frosted123456/Fishing_system_v2/log/chalet_ball_d102_d103.png

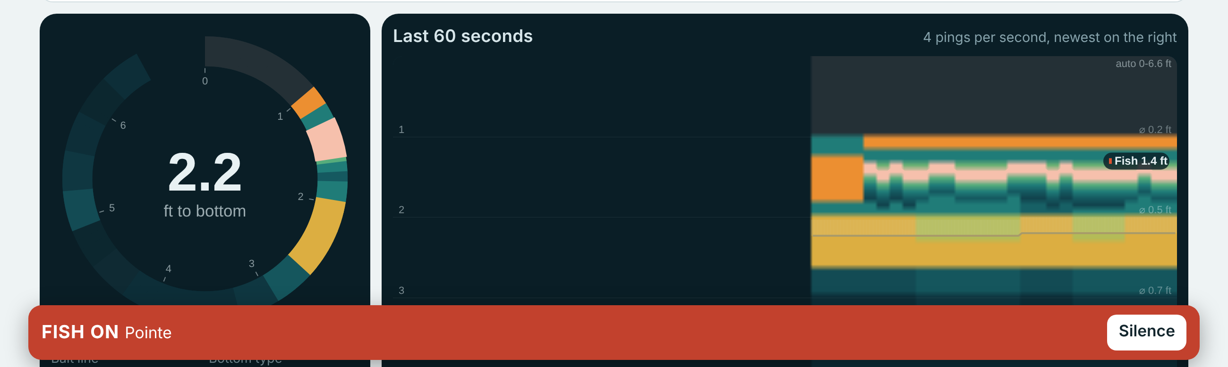
log/chalet_ball_d102_d103.png
