frosted123456/Fishing_system_v2/log/chalet_ball_fine_cells.png

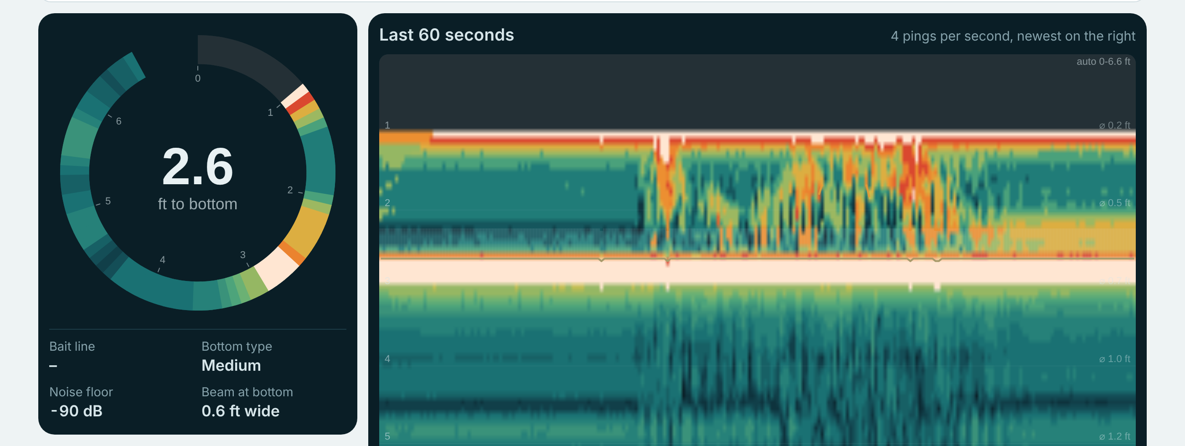
log/chalet_ball_fine_cells.png
