frosted123456/Fishing_system_v2/log/chain_ball_test_2026-11-05.png

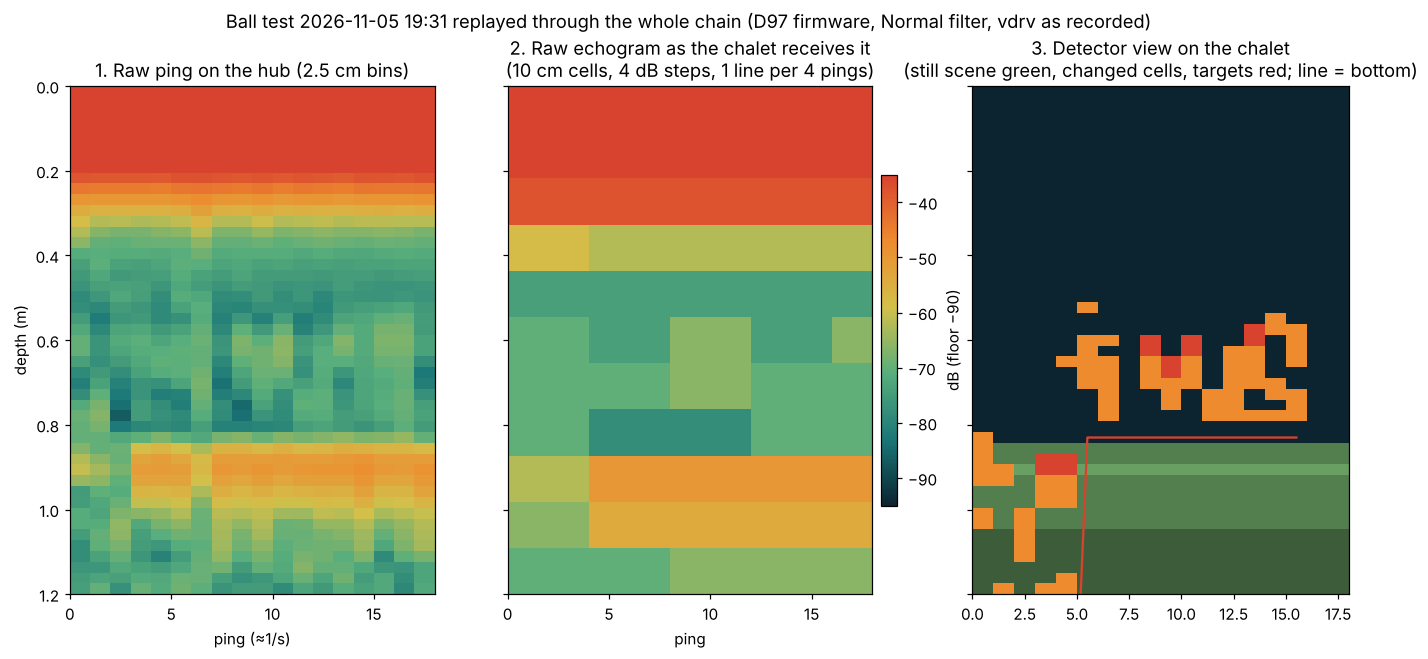
log/chain_ball_test_2026-11-05.png
