frosted123456/Fishing_system_v2/src/lora_node/mesh_radio.cpp

// TDMA LoRa mesh — radio task. See mesh_radio.h and docs/protocol_v2.md.
//
// Timing: every slot time is relative to REF = start of the chalet beacon, computed as
// TxDone - airtime(beacon) at the chalet and RxDone - airtime(beacon) at a hub (or from a relay
// hub's ECHO), so REF is exactly periodic whatever the beacon length. Interrupt
// times are taken in the DIO1 ISR with esp_timer_get_time(); TX starts are placed with
// vTaskDelay + a short busy-wait. Values marked "est." are estimates for the radio test mode.
#include "mesh_radio.h"
#include <RadioLib.h>
#include <new>
#include <esp_heap_caps.h>
#include <esp_timer.h>
#include <esp_system.h>
#include <freertos/FreeRTOS.h>
#include <freertos/task.h>
#include <freertos/semphr.h>
#include <freertos/queue.h>
#include "config.h"
#include <hub_role.h>
#include <follow_action.h>   // D80
#include <chalet_role.h>
#include <sonar_link.h>
#include <eb_link.h>
#include <sonar_sim.h>

using namespace icemesh;
using namespace icemesh::tdma;

// ---------------------------------------------------------------------------------------------
// Radio + shared state
// ---------------------------------------------------------------------------------------------
// D84: RadioLib keeps getMod() protected; the fallback-mode command after begin() needs it (see meshRadioBegin)
struct Sx1262Radio : public SX1262 { using SX1262::SX1262; Module* module() { return getMod(); } };
static Sx1262Radio radio = new Module(LORA_CS, LORA_DIO1, LORA_RST, LORA_BUSY, SPI, SPISettings(8000000, MSBFIRST, SPI_MODE0));   // radio review: 8 MHz halves the per-byte cost of a 255 B packet

static TaskHandle_t g_task = nullptr;
static SemaphoreHandle_t g_mx = nullptr;
static QueueHandle_t g_nodeq = nullptr;

static volatile bool g_irq = false;
static volatile uint32_t g_irq_us = 0;

static bool g_chalet = false;
static bool g_radio_ok = false;
static uint8_t g_net = 0x42;
static RadioMode g_cur_mode = MODE_COUNT;

static HubRole<24>* g_hub = nullptr;
static ChaletRole<10, 48>* g_ch = nullptr;   // 10 hubs, 48 nodes (3 tip-ups per hub + spares)

// counters (written by the task, read by loop)
static volatile uint32_t g_rx_ok = 0, g_rx_crc = 0, g_tx = 0, g_last_rx_ms = 0;
static volatile uint16_t g_frame = 0;

// hub side state shared with loop
static volatile uint16_t g_battery_mv = 0;
static volatile uint8_t g_silence_req = 0;        // HF_SILENCE_ON / HF_SILENCE_OFF while pending
static volatile uint8_t g_silence_req_frames = 0;
static volatile bool g_silence_event = false;
static volatile bool g_silence_state = false;
static volatile bool g_reset_event = false;
// Survives ESP.restart() (not power-off): the RESET ALL already executed, so the beacon repeating it
// for 5 s does not reboot this hub a second time.
RTC_NOINIT_ATTR static uint32_t g_rtc_cmd_magic;
RTC_NOINIT_ATTR static uint8_t g_rtc_cmd_seq;
static uint32_t g_test_counter = 0;
static uint16_t g_last_beacon_len = 40;

// chalet side config shared with loop
static volatile uint8_t g_cfg_test = TEST_OFF;
static volatile bool g_cfg_adaptive = false;
static volatile bool g_cfg_reset_stats = false;
static volatile uint8_t g_cfg_focus = 0;
// D81 (5.1): frames are 0.5-2 s long: ages for people and the follower are in seconds
static uint16_t frameAgeS(uint16_t frame_then);
static uint16_t frameAgeS(uint16_t frame_then) {
  const uint16_t fm = (g_chalet && g_ch != nullptr && g_ch->planner.frameMs()) ? g_ch->planner.frameMs() : 1000;
  const uint32_t frames = static_cast<uint16_t>(g_frame - frame_then);
  const uint32_t ms = frames * fm;
  return ms > 65535000UL ? 65535 : static_cast<uint16_t>(ms / 1000UL);
}
static volatile uint8_t g_cfg_range_hub = 0;          // D80 range test hub (0 = off)
static RangeRing<64> g_range_ring;                     // D80 slot results of that hub (radio task -> loop)
static sonar::FollowAction g_follow;                   // D80 follow the action (chalet, loop() only)
static volatile bool g_cfg_reset_all = false;
static volatile bool g_cfg_sonar_sim = false;
// D70: the chalet keeps the last wiring-check result of each hole (SEC_SELFTEST), on top of the sonar store
static constexpr uint16_t SONAR_RING = 96;   // D84c: pings kept (was 128); 3 streamed holes = 32 each, the page polls every 2 s
static constexpr uint8_t SONAR_HIST = 60;    // D84c: summaries per hole for the glance views, 2 min at one per 2 s (was 90 = 3 min)
struct ChaletSink : public sonar::SonarStore<16, SONAR_RING, SONAR_HIST> {
  struct R { uint8_t node; uint8_t r[12]; uint32_t at_ms; };
  R st[16]; uint8_t st_n = 0;
  R tn[16]; uint8_t tn_n = 0;   // D141: last transducer-tune result of each hole (same section, 12 B with version 2)
  void onSelfTest(uint8_t, uint8_t node, const uint8_t* r12, uint16_t) override {
    const bool tune = r12[0] == 2;   // icemesh::sonar::TUNE_RESULT_VER
    R* a = tune ? tn : st; uint8_t& n = tune ? tn_n : st_n;
    R* p = nullptr;
    for (uint8_t i = 0; i < n && p == nullptr; i++) if (a[i].node == node) p = &a[i];
    if (p == nullptr) { if (n < 16) p = &a[n++]; else p = &a[0]; }
    p->node = node; memcpy(p->r, r12, 12); p->at_ms = millis() ? millis() : 1;
  }
};
static ChaletSink* g_sonar = nullptr;   // chalet only (~35 KB: ping ring 96 x 112 B, 16 holes x 564 B, history 16 x 60 x 16 B; D84c shrank it from 46 KB for heap room with the demo)
static uint8_t g_cmd_seq = 0;
static uint32_t g_silence_until_ms = 0;
static uint8_t g_self = 0;

// ---- v2 network config: LoRa channel, transport, ESP-NOW backbone (docs/protocol_v2.md §6c) ----
// Values marked est. come from the simulation (docs/SIM_RESULTS.md), not from field measurements.
static const int16_t BUSY_ABOVE_X10 = 80;       // est.: a sample 8 dB above the channel's own noise floor counts as activity (D84h)
static const uint8_t CH_BUSY_PCT = 25;          // est.: Auto moves away from a channel busier than this...
static const uint8_t CH_BETTER_PCT = 15;        // ...when another one is quieter by at least this much
static const uint32_t CH_EVAL_MS = 60000;
static const uint32_t SCAN_DWELL_US = 60000;    // chalet: one other channel sampled per frame (between frames)
static const uint32_t BOOT_SCAN_US = 250000;    // chalet: per channel at boot (Auto)
static const uint32_t HUB_HOP_MS = 2500;        // hub without beacon: next channel every 2.5 s...
static const uint32_t HUB_HOP_QUIET_MS = 10000; // ...unless this network was heard in the last 10 s
static const uint8_t CMD_BEACONS = 6;           // each beacon command is repeated in 6 beacons (SET_CHANNEL: target 5..0)
static const uint8_t CMD_BEACONS_KNOB = 3;      // D68: sonar knobs (22 of them on every new hub) take 3: a hub out of a beacon
                                                // or two still gets them, and the queue drains in a minute instead of two
static const bool EB_LR = ESPNOW_LONG_RANGE_MODE;   // backbone rate follows the ice side (LR on hubs and tip-ups)

static volatile uint8_t g_lora_ch = 0;          // network channel
static uint8_t g_tuned_ch = 0;                  // channel the SX1262 is tuned to (radio task only)
static volatile uint8_t g_req_ch = 0xFF;        // hub: channel named by a backbone beacon (applied by the radio task)
static volatile uint32_t g_heard_net_ms = 0;    // hub: last packet of this network (LoRa) or backbone channel hint
static uint32_t g_last_hop_ms = 0;
static volatile uint32_t g_pending_since_ms = 0;
static volatile bool g_lora_idle = false;       // hub: LoRa off (ESP-NOW only)
static volatile bool g_ch_event = false;
static volatile uint8_t g_cfg_transport = TR_AUTO;
static volatile uint8_t g_cfg_channel = MESH_CH_AUTO;
static volatile bool g_cfg_rescan = false;
static volatile uint8_t g_busy_pct[LORA_CHANNELS] = {255, 255, 255, 255, 255, 255, 255, 255};
static uint32_t g_busy_n[LORA_CHANNELS], g_busy_hit[LORA_CHANNELS];   // radio task only
// D84h/i: noise floor per channel = the running MEDIAN of the RSSI samples, dBm x10 (0 = none yet): each sample
// moves it 0.1 dB towards itself, so it settles where half the samples are below. (D84h tracked the lowest sample:
// the SX1262 instantaneous RSSI jitters ±10 dB, one low outlier became the floor and everything read 99 %.) A fixed
// -100 dBm threshold read 70-98 % on every channel indoors: the BW500 floor sits near -105 and the board's own
// noise peaks above -100. With the median, quiet noise gives a few %, a real transmitter on the channel much more.
static volatile int16_t g_floor_x10[LORA_CHANNELS];
static uint8_t g_scan_rr = 0;
static uint32_t g_ch_eval_ms = 0;
static volatile uint16_t g_ch_moves = 0;
static uint8_t g_ch_switch_after = 0xFF;        // chalet: retune at the end of this frame
static volatile uint32_t g_eb_beacon_until_ms = 0;
struct QueuedCmd { uint8_t cmd, target, value; };
static QueuedCmd g_cmdq[40];                    // chalet, under lock (D68: 22 knobs + bait depths + user commands)
static uint8_t g_cmdq_n = 0;
static uint8_t g_cmd_beacons_left = 0;
// backbone
static MeshEbSendFn g_eb_send = nullptr;
static volatile bool g_eb_relay = false;
static eb::Dedup* g_dedup = nullptr;            // under lock
static eb::TransportPolicy g_pol;               // hub, under lock
static uint16_t g_eb_seq = 0;
static uint32_t g_eb_last_ms = 0;
static volatile bool g_eb_kick = false;
static volatile bool g_hub_eb_on = false, g_hub_lora_on = true;
static volatile uint32_t g_eb_rx = 0, g_eb_tx = 0, g_eb_relayed = 0, g_eb_dup = 0;
static volatile uint32_t g_eb_beacon_ms = 0;    // hub: last backbone beacon
static volatile bool g_eb_beacon_seen = false;
static volatile uint32_t g_eb_hub_last_ms = 0;  // chalet: last hub packet over the backbone
// device commands from the chalet beacon for loop() (SET_RELAY, SET_SIM), small queue
struct DevCmdEvt { uint8_t cmd, target, value; };
static DevCmdEvt g_devq[4];
static volatile uint8_t g_devq_n = 0;   // under lock
struct HubPath { uint8_t id, flags, hops; uint32_t lora_ms, eb_ms; bool demo; };
static HubPath g_paths[12];                     // chalet, under lock: how each hub was last heard
// Setup phase (chalet): no automatic channel move until a hub has been in the network for 5 min, or
// 10 min after boot (a channel so busy that no hub can join). Hubs: TransportPolicy::armed().
static const uint32_t CH_ARM_HUB_MS = 300000, CH_ARM_BOOT_MS = 600000;
static volatile uint32_t g_first_hub_ms = 0;
static bool chaletArmed() {
  const uint32_t now = millis();
  return (g_first_hub_ms != 0 && now - g_first_hub_ms >= CH_ARM_HUB_MS) || now >= CH_ARM_BOOT_MS;
}
static uint32_t chaletArmInS() {
  if (chaletArmed()) return 0;
  const uint32_t now = millis();
  uint32_t a = CH_ARM_BOOT_MS - now;
  if (g_first_hub_ms != 0) { const uint32_t b = CH_ARM_HUB_MS - (now - g_first_hub_ms); if (b < a) a = b; }
  return (a + 999) / 1000;
}

struct Lock {
  Lock() { xSemaphoreTake(g_mx, portMAX_DELAY); }
  ~Lock() { xSemaphoreGive(g_mx); }
};

static inline uint32_t nowUs() { return static_cast<uint32_t>(esp_timer_get_time()); }
static inline bool reached(uint32_t t) { return static_cast<int32_t>(nowUs() - t) >= 0; }

static void IRAM_ATTR onDio1() {
  g_irq_us = static_cast<uint32_t>(esp_timer_get_time());
  g_irq = true;
  BaseType_t woken = pdFALSE;
  if (g_task != nullptr) vTaskNotifyGiveFromISR(g_task, &woken);
  if (woken) portYIELD_FROM_ISR();
}

static void sleepUntil(uint32_t t_us) {
  int32_t d = static_cast<int32_t>(t_us - nowUs());
  if (d > 3000) vTaskDelay(pdMS_TO_TICKS((d - 2000) / 1000));
  while (static_cast<int32_t>(t_us - nowUs()) > 0) { /* short busy-wait for an exact TX start */ }
}

// Wait for DIO1 until `deadline_us`. Returns true on interrupt.
static bool waitIrq(uint32_t deadline_us) {
  for (;;) {
    if (g_irq) return true;
    const int32_t rem = static_cast<int32_t>(deadline_us - nowUs());
    if (rem <= 0) return g_irq;
    if (rem < 1500) continue;                       // last ms: spin, a tick would overshoot the deadline
    ulTaskNotifyTake(pdTRUE, pdMS_TO_TICKS((rem - 1000) / 1000));
  }
}

static void clearIrq() { g_irq = false; ulTaskNotifyTake(pdTRUE, 0); }

// Standby with the oscillator kept running: STDBY_RC would make every TX/RX start wait for the
// TCXO again (RadioLib's TCXO delay, ~5 ms by default — longer than the 3 ms slot LEAD).
static inline void standbyXosc() { radio.standby(RADIOLIB_SX126X_STANDBY_XOSC); }

static bool setMode(RadioMode m) {
  if (m == g_cur_mode) return true;
  standbyXosc();
  const ModeInfo& mi = modeInfo(m);
  int s1 = radio.setBandwidth(static_cast<float>(mi.bw_khz));
  int s2 = radio.setSpreadingFactor(mi.sf);
  int s3 = radio.setPreambleLength(modePhy(m).preamble);   // D79: 12 symbols at SF5 / SF6, 8 otherwise (airtime.h agrees)
  if (s1 != RADIOLIB_ERR_NONE || s2 != RADIOLIB_ERR_NONE || s3 != RADIOLIB_ERR_NONE) { g_cur_mode = MODE_COUNT; return false; }
  g_cur_mode = m;
  return true;
}

static volatile uint32_t g_tx_late_skips = 0;
static const uint32_t MAX_TX_LATE_US = 2000;   // est.: later than this, the packet would overrun its slot (LEAD is 6 ms)
// D62: radio state for the sonar capture on the hub (meshLoraQuiet): a transmit on the air, when the last one
// ended, and when the next own transmission is planned (hubFrame / hubSearch; 0 = none known)
static volatile bool g_tx_busy = false;
static volatile uint32_t g_tx_end_us = 0;
static volatile uint32_t g_next_tx_us = 0;

// Transmit at `at_us`. Slot transmissions (slot = true) are dropped if we are already more than
// MAX_TX_LATE_US late; others go out now. `end_us` = TxDone time.
static bool txAt(const uint8_t* buf, size_t len, RadioMode m, uint32_t at_us, uint32_t& end_us, bool slot = true) {
  if (!g_radio_ok || len == 0) return false;
  setMode(m);
  sleepUntil(at_us);
  if (slot && static_cast<int32_t>(nowUs() - at_us) > static_cast<int32_t>(MAX_TX_LATE_US)) {
    g_tx_late_skips = g_tx_late_skips + 1;
    return false;
  }
  clearIrq();
  g_tx_busy = true;
  if (radio.startTransmit(buf, len) != RADIOLIB_ERR_NONE) { standbyXosc(); g_tx_busy = false; return false; }
  const uint32_t limit = nowUs() + modeAirtimeUs(m, static_cast<uint16_t>(len)) + 50000;   // est. margin
  const bool ok = waitIrq(limit);
  end_us = ok ? g_irq_us : nowUs();
  radio.finishTransmit();
  standbyXosc();
  g_tx_end_us = nowUs(); g_tx_busy = false;
  if (ok) g_tx = g_tx + 1;
  return ok;
}

// ---- LoRa channel + activity meter ----
static void tune(uint8_t ch) {
  if (!g_radio_ok || ch >= LORA_CHANNELS || ch == g_tuned_ch) return;
  standbyXosc();
  if (radio.setFrequency(loraChannelMHz(ch)) == RADIOLIB_ERR_NONE) g_tuned_ch = ch;
}

// One instantaneous RSSI sample (radio in RX) for the activity meter of channel ch.
static inline void busySample(uint8_t ch) {
  if (ch >= LORA_CHANNELS) return;
  const int16_t x = static_cast<int16_t>(radio.getRSSI(false) * 10.0f);
  if (g_floor_x10[ch] == 0) { g_floor_x10[ch] = x; return; }
  g_floor_x10[ch] = g_floor_x10[ch] + (x < g_floor_x10[ch] ? -1 : 1);
  g_busy_n[ch]++;
  if (x > g_floor_x10[ch] + BUSY_ABOVE_X10) g_busy_hit[ch]++;
}

// waitIrq() that also samples the RSSI about once per ms (FreeRTOS tick) while waiting.
static bool waitIrqSampling(uint32_t deadline_us, uint8_t ch) {
  for (;;) {
    if (g_irq) return true;
    const int32_t rem = static_cast<int32_t>(deadline_us - nowUs());
    if (rem <= 0) return g_irq;
    if (rem < 2500) return waitIrq(deadline_us);
    busySample(ch);
    ulTaskNotifyTake(pdTRUE, 1);
  }
}

// Listen on channel ch until until_us only to measure activity (nothing is decoded), then retune
// to the network channel.
static void sampleChannel(uint8_t ch, uint32_t until_us) {
  if (!g_radio_ok) { sleepUntil(until_us); return; }
  tune(ch);
  setMode(MODE_SF9_BW500);
  clearIrq();
  radio.startReceive();
  while (static_cast<int32_t>(until_us - nowUs()) > 2500) {
    busySample(ch);
    vTaskDelay(1);
  }
  sleepUntil(until_us);
  standbyXosc();
  clearIrq();
  tune(g_lora_ch);
}

// Busy % per channel from the samples, then halve the counters (older samples fade out).
static void busyPublish() {
  for (uint8_t c = 0; c < LORA_CHANNELS; c++) {
    if (g_busy_n[c] >= 50) g_busy_pct[c] = static_cast<uint8_t>((g_busy_hit[c] * 100UL + g_busy_n[c] / 2) / g_busy_n[c]);
    g_busy_n[c] /= 2; g_busy_hit[c] /= 2;
  }
}

// Auto rule (same as the simulation): stay unless the current channel is busier than CH_BUSY_PCT and
// another one is quieter by CH_BETTER_PCT; 915.0 MHz (channel 0) gets a 5 % preference. -1 = stay.
static int betterChannel(uint8_t cur) {
  const uint8_t pc = g_busy_pct[cur];
  if (pc == 255 || pc <= CH_BUSY_PCT) return -1;
  int best = -1, bq = 1000;
  for (uint8_t c = 0; c < LORA_CHANNELS; c++) {
    if (c == cur || g_busy_pct[c] == 255) continue;
    const int q = g_busy_pct[c] - (c == 0 ? 5 : 0);
    if (q < bq) { bq = q; best = c; }
  }
  if (best >= 0 && g_busy_pct[best] + CH_BETTER_PCT < pc) return best;
  return -1;
}

struct RxRes { bool irq; bool got; bool crc; uint8_t len; int8_t rssi; int8_t snr_q4; uint32_t end_us; };

static const uint32_t RX_EXTEND_US = 2000;     // est.: < LEAD_US, so a late packet never eats the next slot

// Listen in mode `m` from `open_us` to `close_us`. A packet whose header arrived before close
// may finish up to `extend_us` later (bounded so it never runs into the next slot / beacon).
// meter_ch < LORA_CHANNELS: also feeds the activity meter while waiting (chalet, between frames).
static RxRes rxWindow(RadioMode m, uint32_t open_us, uint32_t close_us, uint8_t* buf, uint32_t extend_us = RX_EXTEND_US,
                      uint8_t meter_ch = 0xFF) {
  RxRes r;
  memset(&r, 0, sizeof(r));
  if (!g_radio_ok) { sleepUntil(close_us); return r; }
  setMode(m);
  if (!reached(open_us)) sleepUntil(open_us);
  if (reached(close_us)) return r;
  clearIrq();
  radio.startReceive();
  bool irq = meter_ch < LORA_CHANNELS ? waitIrqSampling(close_us, meter_ch) : waitIrq(close_us);
  if (!irq) {
    const uint32_t flags = radio.getIrqFlags();
    if ((flags & 0x0010) && extend_us > 0) irq = waitIrq(close_us + extend_us);   // HeaderValid: packet in progress
  }
  if (irq) {
    r.irq = true;
    r.end_us = g_irq_us;
    const size_t n = radio.getPacketLength();
    if (n > 0 && n <= MAX_PACKET) {
      const int st = radio.readData(buf, n);
      if (st == RADIOLIB_ERR_NONE) {
        r.got = true; r.len = static_cast<uint8_t>(n);
        r.rssi = static_cast<int8_t>(radio.getRSSI());
        r.snr_q4 = static_cast<int8_t>(radio.getSNR() * 4.0f);
        g_rx_ok = g_rx_ok + 1;
        g_last_rx_ms = millis();
      } else if (st == RADIOLIB_ERR_CRC_MISMATCH) {
        r.crc = true;
        g_rx_crc = g_rx_crc + 1;
      }
    }
  }
  standbyXosc();
  return r;
}

// ---------------------------------------------------------------------------------------------
// Chalet
// ---------------------------------------------------------------------------------------------
static void cmdQueue(uint8_t cmd, uint8_t target, uint8_t value) {   // under lock
  if (cmd == CMD_SET_CHANNEL) {
    if (g_ch->cmd == CMD_SET_CHANNEL && g_ch->cmd_value == value) return;          // that switch is running
    for (uint8_t i = 0; i < g_cmdq_n; i++)
      if (g_cmdq[i].cmd == CMD_SET_CHANNEL) { g_cmdq[i].value = value; return; }   // newest choice wins
  }
  if (cmd == CMD_SET_SIM || cmd == CMD_SET_RELAY || cmd == CMD_SONAR_PARAM || cmd == CMD_SET_BAIT || cmd == CMD_SET_ARM || cmd == CMD_SELFTEST) {   // same target: newest value wins
    for (uint8_t i = 0; i < g_cmdq_n; i++)
      if (g_cmdq[i].cmd == cmd && g_cmdq[i].target == target) { g_cmdq[i].value = value; return; }
  }
  const uint8_t cap = sizeof(g_cmdq) / sizeof(g_cmdq[0]);
  if (g_cmdq_n >= cap) return;
  // D68: a command a person just gave (arm, bait) goes ahead of the knob resends; a knob being beaconed right now is
  // pushed back behind it (with its beacons restarted) so the user command goes out in the next beacon.
  const bool user = cmd == CMD_SET_ARM || cmd == CMD_SET_BAIT || cmd == CMD_SELFTEST;
  uint8_t at = g_cmdq_n;
  if (user) {
    at = 0;
    while (at < g_cmdq_n && (g_cmdq[at].cmd == CMD_SET_ARM || g_cmdq[at].cmd == CMD_SET_BAIT || g_cmdq[at].cmd == CMD_SELFTEST || g_cmdq[at].cmd == CMD_RESET_ALL || g_cmdq[at].cmd == CMD_SET_CHANNEL)) at++;
    if (g_ch->cmd == CMD_SONAR_PARAM && g_cmd_beacons_left > 0 && g_cmdq_n + 1 < cap) {
      for (uint8_t i = g_cmdq_n; i > at; i--) g_cmdq[i] = g_cmdq[i - 1];
      g_cmdq[at].cmd = g_ch->cmd; g_cmdq[at].target = g_ch->cmd_target; g_cmdq[at].value = g_ch->cmd_value; g_cmdq_n++;
      g_cmd_beacons_left = 0;   // chaletApplyConfig ends it and takes the head of the queue
    }
  }
  for (uint8_t i = g_cmdq_n; i > at; i--) g_cmdq[i] = g_cmdq[i - 1];
  g_cmdq[at].cmd = cmd; g_cmdq[at].target = target; g_cmdq[at].value = value; g_cmdq_n++;
}

// D68: is this command still on its way (queued or being beaconed)? For the page: "sent, waiting for the hole".
bool meshCmdPending(uint8_t cmd, uint8_t target, uint8_t& value) {
  if (!g_chalet || g_ch == nullptr) return false;
  Lock l;
  if (g_ch->cmd == cmd && g_ch->cmd_target == target && g_cmd_beacons_left > 0) { value = g_ch->cmd_value; return true; }
  for (uint8_t i = 0; i < g_cmdq_n; i++) if (g_cmdq[i].cmd == cmd && g_cmdq[i].target == target) { value = g_cmdq[i].value; return true; }
  return false;
}

static void chaletApplyConfig() {   // under lock
  PlannerConfig& c = g_ch->planner.cfg;
  if (c.test_mode != g_cfg_test) { c.test_mode = g_cfg_test; g_ch->planner.resetStats(); }
  c.adaptive = g_cfg_adaptive;
  if (g_cfg_reset_stats) { g_ch->planner.resetStats(); g_cfg_reset_stats = false; }
  g_ch->focus_node = g_cfg_focus;
  for (uint8_t k = 0; k < 2; k++) g_ch->focus_extra[k] = (g_follow.extra[k] != g_cfg_focus) ? g_follow.extra[k] : 0;   // D81 (5.4); D82: with follow off too
  c.range_hub = g_cfg_range_hub;   // D80
  if (g_cfg_reset_all) { g_cfg_reset_all = false; cmdQueue(CMD_RESET_ALL, 0, 0); }
  // one command at a time, each in CMD_BEACONS beacons (also sent on the backbone)
  if (g_ch->cmd != CMD_NONE && g_cmd_beacons_left == 0) g_ch->cmd = CMD_NONE;
  if (g_ch->cmd == CMD_NONE && g_cmdq_n > 0) {
    const QueuedCmd q = g_cmdq[0];
    for (uint8_t i = 1; i < g_cmdq_n; i++) g_cmdq[i - 1] = g_cmdq[i];
    g_cmdq_n--;
    g_cmd_seq++;
    if (g_cmd_seq == 0) g_cmd_seq = 1;   // a hub starts with last seq 0
    g_ch->cmd = q.cmd; g_ch->cmd_seq = g_cmd_seq; g_ch->cmd_target = q.target; g_ch->cmd_value = q.value;
    g_cmd_beacons_left = q.cmd == CMD_SONAR_PARAM ? CMD_BEACONS_KNOB : CMD_BEACONS;   // D68
  }
  if (g_ch->cmd == CMD_SET_CHANNEL) g_ch->cmd_target = static_cast<uint8_t>(g_cmd_beacons_left - 1);   // beacons left before the switch
  const bool silenced = g_silence_state && static_cast<int32_t>(g_silence_until_ms - millis()) > 0;
  if (g_silence_state && !silenced) { g_silence_state = false; g_silence_event = true; }
  g_ch->flags = static_cast<uint8_t>((silenced ? BF_SILENCED : 0) | (g_cfg_sonar_sim ? BF_SONAR_SIM : 0));
  const uint32_t rem_s = silenced ? (g_silence_until_ms - millis()) / 1000 : 0;
  g_ch->silence_10s = static_cast<uint8_t>(rem_s / 10 > 255 ? 255 : rem_s / 10);
  g_ch->net_cfg = makeNetCfg(g_cfg_transport, EB_LR, g_lora_ch);
}

static void chaletBeaconBuilt() {   // under lock, after startFrame
  if (g_ch->cmd == CMD_NONE || g_cmd_beacons_left == 0) return;
  g_cmd_beacons_left--;
  if (g_ch->cmd == CMD_SET_CHANNEL && g_cmd_beacons_left == 0) g_ch_switch_after = g_ch->cmd_value;   // after the target-0 beacon
}

static void notePath(uint8_t hub, uint8_t flags, bool eb, uint8_t hops) {   // under lock
  HubPath* p = nullptr;
  for (uint8_t i = 0; i < 12 && p == nullptr; i++) if (g_paths[i].id == hub) p = &g_paths[i];
  for (uint8_t i = 0; i < 12 && p == nullptr; i++) if (g_paths[i].id == 0) p = &g_paths[i];
  if (p == nullptr) {   // replace the hub heard longest ago
    p = &g_paths[0];
    for (uint8_t i = 1; i < 12; i++) {
      const uint32_t a = g_paths[i].lora_ms > g_paths[i].eb_ms ? g_paths[i].lora_ms : g_paths[i].eb_ms;
      const uint32_t b = p->lora_ms > p->eb_ms ? p->lora_ms : p->eb_ms;
      if (a < b) p = &g_paths[i];
    }
    memset(p, 0, sizeof(*p));
  }
  p->id = hub; p->flags = flags;
  if (eb) { p->eb_ms = millis(); p->hops = hops; } else { p->lora_ms = millis(); }
}

static void chaletHandle(const ChaletRxResult& res, bool eb = false, uint8_t hops = 0) {   // under lock
  if (res.hub != 0 && res.hub != ID_NONE) notePath(res.hub, res.flags, eb, hops);
  for (uint8_t k = 0; k < res.n_changes; k++) {
    MeshNodeUpdate u;
    u.node = res.changes[k].node; u.owner = res.changes[k].owner; u.old_state = res.changes[k].old_state;
    u.new_state = res.changes[k].new_state; u.turns = res.changes[k].turns; u.flags = res.changes[k].flags;
    xQueueSend(g_nodeq, &u, 0);
  }
  if (res.flags & HF_SILENCE_ON) {
    if (!g_silence_state) g_silence_event = true;
    g_silence_state = true; g_silence_until_ms = millis() + SILENCE_AUTO_CLEAR_MS;
  } else if (res.flags & HF_SILENCE_OFF) {
    if (g_silence_state) g_silence_event = true;
    g_silence_state = false;
  }
}

// Boot: fixed channel, or (Auto) the channel used last time — every device starts there, so the
// network comes up the same way however the devices are switched on. The scan only fills the
// activity meter; Auto moves wait for the end of the setup phase (chaletArmed).
static void chaletBootChannel() {
  if (g_cfg_channel < LORA_CHANNELS) { g_lora_ch = g_cfg_channel; tune(g_lora_ch); return; }
  tune(g_lora_ch);
  for (uint8_t c = 0; c < LORA_CHANNELS; c++) sampleChannel(c, nowUs() + BOOT_SCAN_US);
  busyPublish();
  tune(g_lora_ch);
}

// Between frames: sample one other channel (round robin), then listen on the network channel for
// random JOINs while sampling its activity. Never runs into the beacon (until = beacon - 4 ms).
static void chaletGap(uint32_t until, bool lora) {
  static uint8_t rx[MAX_PACKET];
  if (static_cast<int32_t>(until - nowUs()) > static_cast<int32_t>(SCAN_DWELL_US + 20000)) {
    g_scan_rr = static_cast<uint8_t>((g_scan_rr + 1) % LORA_CHANNELS);
    if (g_scan_rr == g_lora_ch) g_scan_rr = static_cast<uint8_t>((g_scan_rr + 1) % LORA_CHANNELS);
    sampleChannel(g_scan_rr, nowUs() + SCAN_DWELL_US);
  }
  while (static_cast<int32_t>(until - nowUs()) > 0) {
    if (lora) {
      RxRes r = rxWindow(MODE_SF9_BW500, nowUs(), until, rx, 0, g_lora_ch);   // never extend into the beacon
      if (r.got) { Lock l; g_ch->onAsyncPacket(rx, r.len, r.rssi); }
    } else {
      sampleChannel(g_lora_ch, until);
    }
  }
}

// Every CH_EVAL_MS (or on request): publish the activity, then queue a channel change if the fixed
// setting differs or (Auto) the channel got busy.
static void chaletChannelEval() {
  if (!g_cfg_rescan && millis() - g_ch_eval_ms < CH_EVAL_MS) return;
  g_cfg_rescan = false;
  g_ch_eval_ms = millis();
  busyPublish();
  int to = -1;
  if (g_cfg_channel < LORA_CHANNELS) { if (g_cfg_channel != g_lora_ch) to = g_cfg_channel; }
  else if (chaletArmed()) to = betterChannel(g_lora_ch);   // setup phase: never move by itself
  if (to >= 0) { Lock l; cmdQueue(CMD_SET_CHANNEL, 0, static_cast<uint8_t>(to)); }
}

static void chaletTask() {
  static uint8_t buf[MAX_PACKET];
  static uint8_t rx[MAX_PACKET];
  static uint8_t ebp[MAX_PACKET];
  static uint8_t ebf[eb::MAX_FRAME];
  uint16_t frame = 1;
  chaletBootChannel();
  g_ch_eval_ms = millis();
  uint32_t next = nowUs() + 200000;
  for (;;) {
    const bool lora = g_cfg_transport != TR_ESPNOW;   // ESP-NOW only: no LoRa TX, frames keep running for the backbone
    chaletGap(next - 4000, lora);
    Beacon plan;
    SlotTime times[MAX_SLOTS];
    size_t blen, eblen = 0;
    uint32_t frame_us;
    {
      Lock l;
      chaletApplyConfig();
      blen = g_ch->startFrame(frame, buf, sizeof(buf));
      chaletBeaconBuilt();
      plan = g_ch->beacon;
      memcpy(times, g_ch->times, sizeof(times));
      // the planner may lengthen the frame (1 / 1.5 / 2 s) when the hubs do not fit
      frame_us = plan.frame_10ms ? static_cast<uint32_t>(plan.frame_10ms) * 10000UL
                                 : static_cast<uint32_t>(g_ch->planner.cfg.frame_ms) * 1000UL;
      g_frame = frame;
      const uint32_t now = millis();
      // backbone beacon: Auto / ESP-NOW, 2 min after leaving them, and while hubs talk on the backbone
      const bool eb_beacon = g_eb_send != nullptr &&
                             (g_cfg_transport != TR_LORA || static_cast<int32_t>(g_eb_beacon_until_ms - now) > 0 ||
                              now - g_eb_hub_last_ms < 30000UL);
      if (eb_beacon) eblen = g_ch->buildEbBeacon(ebp, sizeof(ebp));
    }
    uint32_t end = 0, ref = next;
    if (lora) {
      if (txAt(buf, blen, MODE_SF9_BW500, next, end, false)) ref = refFromBeaconEnd(end, static_cast<uint16_t>(blen));
    } else {
      sleepUntil(next);
    }
    if (eblen > 0) {
      eb::Header h;
      h.net = g_net; h.sender = g_self; h.type = eb::MSG_EB_BEACON; h.hops = 0; h.origin = g_self; h.seq = ++g_eb_seq;
      const size_t n = eb::encode(h, ebp, eblen, ebf, sizeof(ebf));
      if (n > 0 && g_eb_send(ebf, n)) g_eb_tx = g_eb_tx + 1;
    }
    for (uint8_t i = 0; lora && i < plan.n_slots; i++) {
      const Slot& s = plan.slots[i];
      if (s.kind == SLOT_ECHO) continue;                         // our own beacon, repeated
      RxRes r = rxWindow(slotMode(s), ref + times[i].start, ref + times[i].end, rx);
      Lock l;
      if (r.got) {
        ChaletRxResult res;
        if (g_ch->onSlotPacket(i, rx, r.len, r.rssi, r.snr_q4, res)) chaletHandle(res);
      } else {
        g_ch->onSlotEmpty(i, r.crc);
      }
    }
    {
      Lock l;
      if (g_first_hub_ms == 0) {   // setup phase clock starts with the first hub in the network
        for (uint8_t i = 0; i < g_ch->planner.capacity(); i++) if (g_ch->planner.hubAt(i) != nullptr) { g_first_hub_ms = millis(); break; }
      }
      NodeChange ex[8];
      const uint8_t n = g_ch->expireNodes(ex, 8);
      for (uint8_t k = 0; k < n; k++) {
        MeshNodeUpdate u = {ex[k].node, ex[k].owner, ex[k].old_state, ex[k].new_state, ex[k].turns, ex[k].flags};
        xQueueSend(g_nodeq, &u, 0);
      }
    }
    if (g_ch_switch_after != 0xFF) {   // the target-0 beacon went out: the network moves now
      g_lora_ch = g_ch_switch_after; g_ch_switch_after = 0xFF;
      tune(g_lora_ch);
      g_ch_moves = g_ch_moves + 1; g_ch_event = true;
    }
    chaletChannelEval();
    frame++;
    next += frame_us;
    if (static_cast<int32_t>(next - nowUs()) < 5000) next = nowUs() + 20000;   // fell behind: restart timing
  }
}

// ---------------------------------------------------------------------------------------------
// Hub
// ---------------------------------------------------------------------------------------------
static void hubBeaconPost(uint8_t cmd) {   // under lock: events for loop
  if (cmd == CMD_RESET_ALL) {
    g_reset_event = true;
    g_rtc_cmd_magic = 0xC0DE5EED; g_rtc_cmd_seq = g_hub->last_cmd_seq;
  }
  if (cmd == CMD_SET_CHANNEL) g_pending_since_ms = millis();
  if ((cmd == CMD_SET_RELAY || cmd == CMD_SET_SIM || cmd == CMD_SONAR_PARAM || cmd == CMD_SET_BAIT || cmd == CMD_SET_ARM || cmd == CMD_SELFTEST) && g_devq_n < 4) {
    g_devq[g_devq_n].cmd = cmd; g_devq[g_devq_n].target = g_hub->last_cmd_target; g_devq[g_devq_n].value = g_hub->last_cmd_value;
    g_devq_n = static_cast<uint8_t>(g_devq_n + 1);
  }
  const bool s = g_hub->silenced();   // beacon or backbone beacon
  if (s != g_silence_state) { g_silence_state = s; g_silence_event = true; }
}

// Handle a packet heard at any time. Returns true if it installed a new plan (beacon/echo).
static bool hubOnPacket(int slot, const uint8_t* p, const RxRes& r) {
  Lock l;
  Header h;
  if (!readHeader(p, r.len, g_net, h)) return false;
  g_heard_net_ms = millis();                      // our network is on this channel: stop hopping
  if (h.type == PT_BEACON || h.type == PT_ECHO) {
    uint8_t cmd = CMD_NONE;
    if (g_hub->onBeacon(p, r.len, r.end_us, r.rssi, r.snr_q4, cmd)) {
      g_pol.onLoraBeacon(millis());
      if (h.type == PT_BEACON) g_last_beacon_len = r.len;
      g_frame = g_hub->plan.frame;
      hubBeaconPost(cmd);
      return true;
    }
    return false;
  }
  if (slot >= 0) g_hub->onSlotPacket(static_cast<uint8_t>(slot), p, r.len, r.rssi, r.snr_q4);
  else g_hub->onAsyncPacket(p, r.len, r.rssi, r.snr_q4);
  return false;
}

// Listen in SF9/500 between open and close; other packets (joins...) don't end the window.
// Returns true when a beacon/echo installed a new plan.
static bool listenFor(uint32_t open_us, uint32_t close_us) {
  static uint8_t rx[MAX_PACKET];
  while (!reached(close_us)) {
    RxRes r = rxWindow(MODE_SF9_BW500, open_us, close_us, rx);
    if (!r.irq) return false;                     // window closed with nothing (more)
    if (r.got && hubOnPacket(-1, rx, r)) return true;
    open_us = nowUs();
  }
  return false;
}

// Radio task: follow a channel switch announced by the chalet (after the target-0 beacon), or, while
// unsynced, the channel named by the backbone beacon.
static void hubChannelUpdate(bool synced) {
  uint8_t to = 0xFF;
  {
    Lock l;
    if (g_hub->channel_switch_pending) {
      g_req_ch = 0xFF;   // the backbone beacon still names the old channel during the countdown
      const bool due = seqDiff(static_cast<uint16_t>(g_hub->frameNow() + 1), g_hub->channel_switch_frame) >= 0;
      if (due || (!synced && millis() - g_pending_since_ms > 15000UL)) {
        to = g_hub->channel_next; g_hub->channel_switch_pending = false;
      }
    } else if (!synced && g_req_ch != 0xFF) {
      to = g_req_ch; g_req_ch = 0xFF;
    }
  }
  if (to < LORA_CHANNELS && to != g_lora_ch) {
    g_lora_ch = to; tune(to); g_ch_event = true;
    g_heard_net_ms = millis();
  }
}

static void hubSearch(uint32_t& next_join_us) {
  static uint8_t rx[MAX_PACKET];
  // no beacon: next channel every HUB_HOP_MS, unless this network was heard recently
  const uint32_t now = millis();
  if (now - g_heard_net_ms > HUB_HOP_QUIET_MS && now - g_last_hop_ms > HUB_HOP_MS) {
    g_lora_ch = static_cast<uint8_t>((g_lora_ch + 1) % LORA_CHANNELS);
    tune(g_lora_ch);
    g_last_hop_ms = now;
  }
  const uint32_t close = nowUs() + 300000;
  RxRes r = rxWindow(MODE_SF9_BW500, nowUs(), close, rx);
  if (r.got && hubOnPacket(-1, rx, r)) return;
  if (reached(next_join_us)) {
    uint8_t jb[MAX_PACKET];
    size_t n;
    { Lock l; n = g_hub->buildJoin(jb, sizeof(jb)); }
    uint32_t end;
    setMode(MODE_SF9_BW500);
    if (radio.scanChannel() == RADIOLIB_LORA_DETECTED) {   // radio review: a JOIN on top of someone's turn costs that turn: listen first (~2 ms CAD)
      next_join_us = nowUs() + 200000 + (esp_random() % 300000);   // busy: try again in 0.2-0.5 s
    } else {
      txAt(jb, n, MODE_SF9_BW500, nowUs(), end, false);
      next_join_us = nowUs() + 1500000 + (esp_random() % 3000000);   // ALOHA: 1.5-4.5 s (est.)
    }
  }
  g_next_tx_us = next_join_us;
}

// D62: the next slot this hub may transmit in, from slot `from` on (own HUB / ECHO slot, or a JOIN slot while it
// has no slot of its own); 0 = none in this plan
static uint32_t nextOwnTxUs(const Beacon& plan, const SlotTime* times, uint32_t ref, uint8_t from, bool own_slot) {
  for (uint8_t i = from; i < plan.n_slots; i++) {
    const Slot& s = plan.slots[i];
    const bool mine = (s.kind == SLOT_HUB || s.kind == SLOT_ECHO) ? (s.owner == g_hub->self) : (s.kind == SLOT_JOIN && !own_slot);
    if (mine) return ref + times[i].tx;
  }
  return 0;
}

// Runs the slots of the current plan that are still ahead. Returns when the frame is done or a
// new plan was installed (echo received mid-frame).
static void hubFrame() {
  static uint8_t buf[MAX_PACKET];
  static uint8_t rx[MAX_PACKET];
  Beacon plan; SlotTime times[MAX_SLOTS]; uint32_t ref; uint32_t frame_us; bool own_slot;
  {
    Lock l;
    plan = g_hub->plan; memcpy(times, g_hub->times, sizeof(times));
    ref = g_hub->sync.ref(); frame_us = g_hub->sync.frameUs();
    own_slot = g_hub->hasOwnSlot();
  }
  for (uint8_t i = 0; i < plan.n_slots; i++) {
    if (static_cast<int32_t>(ref + times[i].end - nowUs()) < 0) continue;     // already past
    g_next_tx_us = nextOwnTxUs(plan, times, ref, i, own_slot);   // D62: for the sonar capture
    const Slot& s = plan.slots[i];
    SlotAction act;
    { Lock l; act = g_hub->action(i, (esp_random() % 3) == 0); }
    uint32_t end;
    switch (act) {
      case ACT_TX_HUB: {
        size_t n;
        {
          Lock l;
          uint8_t flags = static_cast<uint8_t>((g_eb_relay ? HF_EB_RELAY : 0) | (g_hub_eb_on ? HF_EB_PATH : 0));
          static uint16_t silence_frame = 0xFFFF;   // D81 (5.3): the silence request counts frames, not packets (a hub may own two turns)
          if (g_silence_req_frames > 0) { flags |= g_silence_req; if (silence_frame != plan.frame) { silence_frame = plan.frame; g_silence_req_frames = g_silence_req_frames - 1; } }
          const bool test = plan.test_mode != TEST_OFF;
          n = g_hub->buildHub(buf, sizeof(buf), flags, g_battery_mv, static_cast<uint16_t>(millis() / 60000UL),
                              test, static_cast<uint16_t>(g_test_counter), nullptr, i);
          g_test_counter++;
        }
        txAt(buf, n, slotMode(s), ref + times[i].tx, end);
        break;
      }
      case ACT_TX_ECHO: {
        size_t n;
        { Lock l; n = g_hub->buildEcho(buf, sizeof(buf)); }
        txAt(buf, n, MODE_SF9_BW500, ref + times[i].tx, end);
        break;
      }
      case ACT_TX_JOIN: {
        size_t n;
        { Lock l; n = g_hub->buildJoin(buf, sizeof(buf)); }
        txAt(buf, n, MODE_SF9_BW500, ref + times[i].tx + (esp_random() % 2000), end);
        break;
      }
      case ACT_RX: {
        RxRes r = rxWindow(slotMode(s), ref + times[i].start, ref + times[i].end, rx);
        if (r.got && hubOnPacket(i, rx, r)) return;     // echo gave a new plan: restart with it
        break;
      }
      default:
        break;
    }
  }
  { Lock l; g_hub->endFrame(); }
  g_next_tx_us = nextOwnTxUs(plan, times, ref + frame_us, 0, own_slot);   // D62: est.: the next frame repeats the plan
  hubChannelUpdate(true);

  // next beacon: listen around its expected start (REF), then the echo slots of the old plan
  // (echo positions shift with the new beacon length, hence the wider windows)
  const uint32_t ref_next = ref + frame_us;
  if (listenFor(ref_next - BEACON_WINDOW_US, beaconListenCloseUs(ref_next, g_last_beacon_len))) return;   // D79 (E1): room for a grown beacon
  for (uint8_t i = 0; i < plan.n_slots && plan.slots[i].kind == SLOT_ECHO; i++) {
    if (plan.slots[i].owner == g_hub->self) continue;
    // radio review: a grown beacon both shifts the echo and makes it longer: close at twice the growth plus the window
    const uint32_t growth = modeAirtimeUs(MODE_SF9_BW500, static_cast<uint16_t>(g_last_beacon_len + BEACON_GROW_MAX)) - modeAirtimeUs(MODE_SF9_BW500, g_last_beacon_len);
    if (listenFor(ref_next + times[i].start - 10000, ref_next + times[i].end + 2 * growth + BEACON_WINDOW_US)) return;
  }
  Lock l;
  g_hub->onBeaconMissed();
  g_frame = g_hub->sync.frame();
}

static void hubTask() {
  uint32_t next_join = nowUs() + 500000 + (esp_random() % 1000000);
  tune(g_lora_ch);
  for (;;) {
    bool synced, lora_on;
    {
      Lock l;
      const uint32_t now = millis();
      g_pol.tick(now);
      lora_on = g_pol.useLora(g_hub->transport(), now);
      if (!lora_on) g_hub->have_plan = false;   // slot timing is stale when LoRa comes back
      synced = g_hub->have_plan && g_hub->sync.synced();
    }
    g_hub_lora_on = lora_on;
    if (!lora_on) {   // ESP-NOW only: radio idle, keep following channel changes for the way back
      if (!g_lora_idle) { standbyXosc(); g_lora_idle = true; g_next_tx_us = 0; }
      hubChannelUpdate(false);
      vTaskDelay(pdMS_TO_TICKS(100));
      continue;
    }
    g_lora_idle = false;
    hubChannelUpdate(synced);
    if (!synced) hubSearch(next_join);
    else hubFrame();
  }
}

// ---------------------------------------------------------------------------------------------
// Task + public API
// ---------------------------------------------------------------------------------------------
static void radioTask(void*) {
  if (g_chalet) chaletTask();
  else hubTask();
}

static bool radioInit() {
  pinMode(VEXT_PIN, OUTPUT);
  digitalWrite(VEXT_PIN, LOW);
  SPI.begin(LORA_SCK, LORA_MISO, LORA_MOSI, LORA_CS);
  const ModeInfo& mi = modeInfo(MODE_SF9_BW500);
  int st = radio.begin(LORA_FREQUENCY, static_cast<float>(mi.bw_khz), mi.sf, LORA_CODING_RATE,
                       LORA_SYNC_WORD, LORA_TX_POWER, LORA_PREAMBLE);
  if (st != RADIOLIB_ERR_NONE) return false;
  // radio review / D84: keep the TCXO running in standby and as the RX/TX fallback mode, otherwise every startReceive /
  // startTransmit waits ~5 ms for the TCXO and the receiver misses SF5-SF7 preambles. Set AFTER begin(): inside begin()
  // the chip is reset and put in standby before the TCXO is enabled, and STANDBY_XOSC fails there ("RADIO INIT FAILED",
  // D83 on the bench). begin() already programmed the fallback mode as STDBY_RC: rewrite it.
  radio.standbyXOSC = true;
  { uint8_t fb = RADIOLIB_SX126X_RX_TX_FALLBACK_MODE_STDBY_XOSC; radio.module()->SPIwriteStream(RADIOLIB_SX126X_CMD_SET_RX_TX_FALLBACK_MODE, &fb, 1); }
  standbyXosc();
  {   // radio review: measure what the slot LEAD / TAIL have to cover on this board, once, at boot
    uint8_t probe[255]; memset(probe, 0x55, sizeof(probe));
    const uint32_t t0 = micros(); radio.startReceive(); const uint32_t t1 = micros(); standbyXosc(); const uint32_t t2 = micros();
    Serial.printf("LoRa timing: startReceive %lu us, standby %lu us (LEAD/TAIL %lu/%lu us)\n", (unsigned long)(t1 - t0), (unsigned long)(t2 - t1), (unsigned long)LEAD_US, (unsigned long)TAIL_US);
  }
  radio.setCRC(2);                       // hardware CRC on (explicit, protocol relies on it)
  radio.setDio1Action(onDio1);
  g_cur_mode = MODE_SF9_BW500;
  return true;
}

bool meshBegin(uint8_t self_id, bool chalet, uint8_t network_id) {
  g_chalet = chalet;
  g_net = network_id;
  g_self = self_id;
  g_mx = xSemaphoreCreateMutex();
  g_dedup = new eb::Dedup();
  g_eb_seq = static_cast<uint16_t>(esp_random());   // a rebooted device must not look like a duplicate
  g_pol.begin(millis());
  g_cmd_seq = static_cast<uint8_t>(esp_random());   // a rebooted chalet must not reuse the last command seq
  g_nodeq = xQueueCreate(32, sizeof(MeshNodeUpdate));
  if (chalet) {
    g_ch = new ChaletRole<10, 48>();
    g_sonar = new ChaletSink();
    g_ch->sonar_sink = g_sonar;
    g_ch->range_ring = &g_range_ring;   // D80
    PlannerConfig& c = g_ch->planner.cfg;
    c.network_id = network_id; c.self_id = self_id; c.frame_ms = 500;   // D81 (5.1): 500 ms base, steps 500/1000/1500/2000 by itself
    c.allowance = 96; c.test_allowance = 160;          // est. budgets, see docs/protocol_v2.md
    c.test_mode = g_cfg_test; c.adaptive = g_cfg_adaptive;
  } else {
    g_hub = new HubRole<24>();
    g_hub->network_id = network_id;
    g_hub->self = self_id;
    if (g_rtc_cmd_magic == 0xC0DE5EED) g_hub->last_cmd_seq = g_rtc_cmd_seq;
  }
  g_radio_ok = radioInit();
  g_tuned_ch = 0;   // radioInit tunes LORA_FREQUENCY = channel 0; the task retunes to g_lora_ch
  // Core 1 (same as loop), higher priority than loop: the radio preempts loop() for slot timing.
  xTaskCreatePinnedToCore(radioTask, "mesh", 8192, nullptr, 5, &g_task, 1);
  return g_radio_ok;
}

void meshHubObserveNode(uint8_t node, uint8_t state, uint16_t turns, uint8_t flags, uint8_t battery_pct) {
  if (g_hub == nullptr) return;
  Lock l;
  if (g_hub->table.observe(node, state, turns, flags, battery_pct, millis())) g_eb_kick = true;
  g_hub->table.expire(millis(), 10UL * 60UL * 1000UL);   // forget nodes silent for 10 min once acked (est.)
}

void meshHubSetBattery(uint16_t mv) { g_battery_mv = mv; }

bool meshLoraQuiet(uint32_t horizon_us, uint32_t guard_us) {
  if (!g_radio_ok || g_lora_idle) return true;
  if (g_tx_busy) return false;
  const uint32_t now = nowUs();
  if (now - g_tx_end_us < guard_us) return false;
  const uint32_t nx = g_next_tx_us;
  if (nx != 0) { const int32_t d = static_cast<int32_t>(nx - now); if (d > 0 && static_cast<uint32_t>(d) < horizon_us) return false; }
  return true;
}

void meshHubView(MeshHubView& v) {
  memset(&v, 0, sizeof(v));
  if (g_hub == nullptr) return;
  Lock l;
  v.synced = g_hub->have_plan && g_hub->sync.synced();
  v.from_echo = g_hub->plan_from_echo;
  v.frame = g_hub->sync.frame();
  v.beacon_rssi = g_hub->beacon_rssi;
  v.beacon_snr = g_hub->beacon_snr_q4 / 4.0f;
  v.lost64 = g_hub->sync.lostLast64();
  v.sync_err_us = g_hub->sync.lastErrUs();
  const int idx = g_hub->ownSlotIndex();
  v.own_slot_mode = idx >= 0 ? g_hub->plan.slots[idx].mode : -1;
  v.allowance = idx >= 0 ? g_hub->plan.slots[idx].allowance : 0;
  v.test_mode = g_hub->plan.test_mode;
  v.beacons = g_hub->beacons_rx; v.echoes = g_hub->echoes_rx; v.tx = g_tx;
  const uint32_t now = millis();
  v.lora_ch = g_lora_ch;
  v.transport = g_hub->transport();
  v.lora_on = g_hub_lora_on; v.eb_on = g_hub_eb_on;
  v.eb_fallback = g_pol.fallbackActive();
  v.eb_beacon_age_ms = g_eb_beacon_seen ? now - g_eb_beacon_ms : 0xFFFFFFFFUL;
  v.relay = g_eb_relay;
}

void meshRequestSilence(bool on) {
  if (g_chalet) {
    if (g_mx == nullptr) return;
    Lock l;
    g_silence_state = on;
    g_silence_until_ms = millis() + SILENCE_AUTO_CLEAR_MS;
  } else {
    g_silence_req = on ? HF_SILENCE_ON : HF_SILENCE_OFF;
    g_silence_req_frames = 3;            // repeated in 3 hub packets (no ack for this request)
  }
}

bool meshPollSilence(bool& on) {
  if (!g_silence_event) return false;
  g_silence_event = false;
  on = g_silence_state;
  return true;
}

bool meshPollReset() {
  if (!g_reset_event) return false;
  g_reset_event = false;
  return true;
}

void meshCounters(MeshCounters& c) {
  c.radio_ok = g_radio_ok; c.rx_ok = g_rx_ok; c.rx_crc = g_rx_crc; c.tx = g_tx;
  c.last_rx_ms = g_last_rx_ms; c.frame = g_frame;
}

uint8_t meshTestMode() {
  if (g_chalet) return g_cfg_test;
  if (g_hub == nullptr) return 0;
  Lock l;
  return g_hub->have_plan ? g_hub->plan.test_mode : 0;
}

bool meshPollNodeUpdate(MeshNodeUpdate& u) {
  return g_nodeq != nullptr && xQueueReceive(g_nodeq, &u, 0) == pdTRUE;
}

uint8_t meshNodeSnapshot(MeshNodeSnapshot* out, uint8_t max) {
  if (g_ch == nullptr) return 0;
  Lock l;
  uint8_t n = 0;
  for (uint8_t i = 0; i < g_ch->nodes.capacity() && n < max; i++) {
    const NodeView* v = g_ch->nodes.at(i);
    if (v == nullptr) continue;
    out[n].node = v->node; out[n].owner = v->owner; out[n].state = v->state;
    out[n].turns = v->turns; out[n].flags = v->flags; out[n].battery = v->battery;
    n++;
  }
  return n;
}

void meshSetTestMode(uint8_t mode) { if (mode < TEST_MODE_COUNT) g_cfg_test = mode; }
void meshSetAdaptive(bool on) { g_cfg_adaptive = on; }
bool meshAdaptive() { return g_cfg_adaptive; }
void meshResetStats() { g_cfg_reset_stats = true; }
void meshSendResetAll() { g_cfg_reset_all = true; }
// D79: a user choice of focus cancels an automatic one
static uint8_t g_autoFocusPrev = 0; static uint32_t g_autoFocusUntil = 0;
void meshSetFocusNode(uint8_t node) {
  g_cfg_focus = node; g_autoFocusUntil = 0;
  if (g_follow.on) g_follow.manual(node, millis());   // D80: a hand pick is kept 5 min, then following resumes
}
// FISH ON on a hole: watch it (4 Hz pings, full waterfall) for AUTO_FOCUS_MS, then back to what was watched before
// (a second trip inside the window re-targets; the user's own choice is what comes back at the end).
// D80: with "follow the action" on, the follower owns this (2 min on the tripped hole, then it follows again).
void meshAutoFocus(uint8_t node) {
  if (!g_chalet || node == 0) return;
  if (g_follow.on) { g_follow.trip(node, millis()); g_cfg_focus = node; return; }
  if (node == g_cfg_focus) return;
  if (g_autoFocusUntil == 0) g_autoFocusPrev = g_cfg_focus;   // remember the user's choice once, not the previous auto one
  g_cfg_focus = node; g_autoFocusUntil = millis() + AUTO_FOCUS_MS;
  if (g_autoFocusUntil == 0) g_autoFocusUntil = 1;
}
void meshAutoFocusTick() {
  if (g_chalet && g_sonar != nullptr) {   // D80: once a second, from the summaries every hole sends (follow off: the extras only, D82)
    static uint32_t last = 0;
    const uint32_t now = millis();
    if (now - last >= 1000) {
      last = now;
      sonar::FollowIn in[16]; uint8_t n = 0;
      {
        Lock l;
        for (uint8_t i = 0; i < g_sonar->capacity() && n < 16; i++) {
          const sonar::NodeSonar* ns = g_sonar->at(i);
          if (ns == nullptr || !ns->has_sum) continue;
          in[n].node = ns->node; in[n].activity = ns->sum.activity; in[n].n_fish = ns->sum.n_targets;
          in[n].near_bait = (ns->sum.status & sonar::ST_NEAR_BAIT) != 0;
          in[n].age_s = frameAgeS(ns->frame);
          n++;
        }
      }
      if (!g_follow.on) g_follow.focus = g_cfg_focus;   // D82: the extras never double the hole the user picked
      if (g_follow.update(in, n, now)) g_cfg_focus = g_follow.focus;
    }
    if (g_follow.on) return;
  }
  if (g_autoFocusUntil == 0 || (int32_t)(millis() - g_autoFocusUntil) < 0) return;
  g_autoFocusUntil = 0; g_cfg_focus = g_autoFocusPrev;
}
void meshSetFollow(bool on) { g_follow.setOn(on, millis()); if (on) g_follow.focus = g_cfg_focus; g_autoFocusUntil = 0; }
void meshSetFollowHoles(uint8_t n) { g_follow.setMaxExtra(n < 1 ? 0 : (n > 3 ? 2 : static_cast<uint8_t>(n - 1))); }
bool meshFollowOn() { return g_follow.on; }
void meshFollowState(char* why, size_t n, uint32_t& pin_s, uint32_t& trip_s) {
  const uint32_t now = millis();
  strlcpy(why, g_follow.why, n); pin_s = g_follow.pinLeftMs(now) / 1000; trip_s = g_follow.tripLeftMs(now) / 1000;
}

// D80 range test: one hub's slot cycles through every mode; the chalet logs each slot result (rangetest.cpp)
void meshRangeStart(uint8_t hub) { g_cfg_range_hub = hub; Lock l; g_range_ring.clear(); }
void meshRangeStop() { g_cfg_range_hub = 0; }
uint8_t meshRangeHub() { return g_cfg_range_hub; }
bool meshRangePop(RangeSample& s) { Lock l; return g_range_ring.pop(s); }
uint32_t meshRangeLost() { return g_range_ring.lost; }
bool meshRangeHubSide(uint8_t hub, RangeHubSide& out, bool& direct, uint8_t& max_sf) {
  memset(&out, 0, sizeof(out)); direct = false; max_sf = 7;
  if (!g_chalet || g_ch == nullptr) return false;
  Lock l;
  const HubInfo* h = g_ch->planner.find(hub);
  if (h == nullptr) return false;
  direct = h->via == 0;
  max_sf = modeInfo(ChaletPlanner<10>::maxModeFor(*h)).sf;
  if (h->has_health) { out.valid = true; out.beacon_rssi = h->health.beacon_rssi; out.beacon_snr_q4 = h->health.beacon_snr_q4; out.beacon_lost64 = h->health.beacon_lost; }
  return true;
}

bool meshHubRelaysOthers(uint8_t hub) {
  if (!g_chalet || g_ch == nullptr || hub == 0) return false;
  Lock l;
  for (uint8_t i = 0; i < 10; i++) { const HubInfo* h = g_ch->planner.hubAt(i); if (h && h->id != hub && h->via == hub) return true; }
  return false;
}

// ---------------------------------------------------------------------------------------------
// v2 network config + ESP-NOW backbone (docs/protocol_v2.md §6c)
// ---------------------------------------------------------------------------------------------
void meshSetStartChannel(uint8_t ch) { if (ch < LORA_CHANNELS) g_lora_ch = ch; }

void meshSetTransport(uint8_t tr) {
  if (tr > TR_PREFER_EB) return;
  if (tr != g_cfg_transport) g_eb_beacon_until_ms = millis() + 120000UL;   // hubs on the backbone hear the change
  g_cfg_transport = tr;
}

bool meshFastEcho() {   // D107: the hub sends a raw echogram line every ping while it is on the ESP-NOW backbone
  if (g_chalet || g_hub == nullptr) return false;
  Lock l;
  return g_pol.ebPreferred();
}

uint8_t meshTransport() {
  if (g_chalet) return g_cfg_transport;
  if (g_hub == nullptr || g_mx == nullptr) return TR_AUTO;
  Lock l;
  return g_hub->transport();
}

void meshSetLoraChannel(uint8_t ch) {
  if (ch >= LORA_CHANNELS && ch != MESH_CH_AUTO) return;
  g_cfg_channel = ch;
  if (g_ch != nullptr) g_cfg_rescan = true;   // radio running: fixed channel applied / Auto re-evaluated now
  else if (ch < LORA_CHANNELS) g_lora_ch = ch;
}
uint8_t meshLoraChannelSetting() { return g_cfg_channel; }
uint8_t meshLoraChannel() { return g_lora_ch; }
float meshLoraChannelMHz(uint8_t ch) { return loraChannelMHz(ch); }
void meshRescanChannels() { g_cfg_rescan = true; }
void meshChannelBusy(uint8_t* pct8) { for (uint8_t c = 0; c < LORA_CHANNELS; c++) pct8[c] = g_busy_pct[c]; }

uint32_t meshSetupArmInS() {
  if (g_mx == nullptr) return 0;
  if (g_chalet) return chaletArmInS();
  Lock l;
  return g_pol.armInS(millis());
}

bool meshPollChannelChanged(uint8_t& ch) {
  if (!g_ch_event) return false;
  g_ch_event = false;
  ch = g_lora_ch;
  return true;
}

void meshSetEbSender(MeshEbSendFn fn) { g_eb_send = fn; }
void meshSetEbRelay(bool on) { g_eb_relay = on; }
bool meshEbRelay() { return g_eb_relay; }

void meshSetDeviceRelay(uint8_t dev, bool on) {
  if (g_ch == nullptr || dev == 0 || dev == ID_NONE) return;
  Lock l;
  cmdQueue(CMD_SET_RELAY, dev, on ? 1 : 0);
}

bool meshPollDevCmd(uint8_t& cmd, uint8_t& target, uint8_t& value) {
  if (g_hub == nullptr || g_devq_n == 0) return false;
  Lock l;
  if (g_devq_n == 0) return false;
  cmd = g_devq[0].cmd; target = g_devq[0].target; value = g_devq[0].value;
  for (uint8_t i = 1; i < g_devq_n; i++) g_devq[i - 1] = g_devq[i];
  g_devq_n = static_cast<uint8_t>(g_devq_n - 1);
  return true;
}

void meshSetBait(uint8_t hole, uint8_t v5) {   // chalet: bait depth of one hole (5 cm steps)
  if (!g_chalet || g_ch == nullptr) return;
  Lock l;
  cmdQueue(CMD_SET_BAIT, hole, v5);
}

// D70: wiring check
void meshSetSelfTest(uint8_t hole) {   // chalet: ask one hole (beacon command, user priority)
  if (!g_chalet || g_ch == nullptr || hole == 0) return;
  Lock l;
  if (g_sonar != nullptr)   // the old result goes: the page shows "waiting" until the fresh one lands
    for (uint8_t i = 0; i < g_sonar->st_n; i++) if (g_sonar->st[i].node == hole) { g_sonar->st[i] = g_sonar->st[--g_sonar->st_n]; break; }
  cmdQueue(CMD_SELFTEST, hole, 0);
}
// D141: transducer tune of one hole (value 1 = run, 2 = forget). Same beacon command as the wiring check, value != 0
void meshSetTune(uint8_t hole, uint8_t value) {
  if (!g_chalet || g_ch == nullptr || hole == 0 || value == 0) return;
  Lock l;
  if (g_sonar != nullptr)   // the old result goes: the page shows "waiting" until the fresh one lands
    for (uint8_t i = 0; i < g_sonar->tn_n; i++) if (g_sonar->tn[i].node == hole) { g_sonar->tn[i] = g_sonar->tn[--g_sonar->tn_n]; break; }
  cmdQueue(CMD_SELFTEST, hole, value);
}
bool meshTuneResult(uint8_t node, uint8_t out12[12], uint32_t& age_ms) {   // chalet: last tune result of a hole
  if (g_sonar == nullptr) return false;
  Lock l;
  for (uint8_t i = 0; i < g_sonar->tn_n; i++) if (g_sonar->tn[i].node == node) { memcpy(out12, g_sonar->tn[i].r, 12); age_ms = millis() - g_sonar->tn[i].at_ms; return true; }
  return false;
}
void meshHubSelfTestReport(uint8_t node, const uint8_t* r12) {   // hub: result in the next 3 packets
  if (g_hub == nullptr) return;
  uint8_t b[SELFTEST_SECTION_LEN]; b[0] = node; memcpy(b + 1, r12, 12);
  Lock l;
  g_hub->setSelfTest(b);
}
bool meshSelfTestResult(uint8_t node, uint8_t out12[12], uint32_t& age_ms) {   // chalet: last result of a hole
  if (g_sonar == nullptr) return false;
  Lock l;
  for (uint8_t i = 0; i < g_sonar->st_n; i++) if (g_sonar->st[i].node == node) { memcpy(out12, g_sonar->st[i].r, 12); age_ms = millis() - g_sonar->st[i].at_ms; return true; }
  return false;
}

void meshSetArm(uint8_t hole, bool armed) {   // chalet: arm / disarm one hole (255 = all), D61
  if (!g_chalet || g_ch == nullptr || hole == 0) return;
  Lock l;
  cmdQueue(CMD_SET_ARM, hole, armed ? 1 : 0);
}

void meshSetSonarParam(uint8_t id, uint8_t value) {   // chalet: one sonar knob for every sonar hole (beacon)
  if (!g_chalet || g_ch == nullptr) return;
  Lock l;
  cmdQueue(CMD_SONAR_PARAM, id, value);
}

void meshSetHoleSim(uint8_t hole, uint8_t value) {
  if (g_ch == nullptr || hole == 0) return;
  Lock l;
  cmdQueue(CMD_SET_SIM, hole, value);
}

// One backbone frame (ESP-NOW type 0x70 / 0x71) from loop(): drop copies, relay, then use it.
void meshEbReceive(const uint8_t* frame, size_t len) {
  if (g_mx == nullptr || g_dedup == nullptr) return;
  eb::Header h;
  const uint8_t* pl;
  size_t n;
  if (!eb::decode(frame, len, g_net, h, pl, n) || h.origin == g_self) return;
  {
    Lock l;
    if (g_dedup->seen(h.origin, h.type, h.seq)) { g_eb_dup = g_eb_dup + 1; return; }
  }
  g_eb_rx = g_eb_rx + 1;
  if (g_eb_relay && g_eb_send != nullptr) {   // relay first: latency adds up per hop
    static uint8_t copy[eb::MAX_FRAME];
    memcpy(copy, frame, len);
    if (eb::prepareRelay(copy, len, g_self) && g_eb_send(copy, len)) g_eb_relayed = g_eb_relayed + 1;
  }
  if (g_chalet) {
    if (h.type != eb::MSG_EB_HUB || g_ch == nullptr) return;
    Lock l;
    ChaletRxResult res;
    g_eb_hub_last_ms = millis();
    if (g_ch->onEbHubPacket(pl, n, h.hops, res)) chaletHandle(res, true, h.hops);
    else if (res.hub != 0) notePath(res.hub, res.flags, true, h.hops);
    return;
  }
  if (h.type != eb::MSG_EB_BEACON || g_hub == nullptr) return;
  Lock l;
  uint8_t cmd = CMD_NONE;
  if (!g_hub->onEbBeacon(pl, n, cmd)) return;
  const uint32_t now = millis();
  g_pol.onEbBeacon(now);
  g_eb_beacon_ms = now; g_eb_beacon_seen = true;
  if (!(g_hub->have_plan && g_hub->sync.synced())) {   // no LoRa beacon: the backbone says which channel
    const uint8_t c = netChannel(g_hub->info_net_cfg);
    if (c < LORA_CHANNELS && c != g_lora_ch && !g_hub->channel_switch_pending) g_req_ch = c;
    g_heard_net_ms = now;
  }
  hubBeaconPost(cmd);
}

// Hub, from loop(): send the hub packet on the backbone when the transport policy says so — every
// second, sooner (250 ms) after a line change.
void meshEbTick() {
  if (g_hub == nullptr || g_mx == nullptr) return;
  static uint8_t pl[eb::MAX_PAYLOAD];
  static uint8_t f[eb::MAX_FRAME];
  size_t n = 0;
  {
    Lock l;
    const uint32_t now = millis();
    g_pol.tick(now);
    const bool use = g_pol.useEb(g_hub->transport(), now);
    g_hub_eb_on = use;
    if (!use || g_eb_send == nullptr) return;
    const uint32_t gap = now - g_eb_last_ms;
    // D110: while the hub streams sonar on the backbone (ESP-NOW preferred, blocks queued), a packet every 250 ms, not 1 s:
    // one 240 B packet a second carries ONE raw echogram line at most (D107's line-per-ping never left the hub). ESP-NOW
    // has the airtime (4 x 250 B/s); LoRa keeps its TDMA slot and 1 line/s.
    const bool stream = g_pol.ebPreferred() && g_hub->sonar.count() > 0;
    if (gap < 1000UL && !((g_eb_kick || stream) && gap >= 250UL)) return;
    g_eb_kick = false;
    g_eb_last_ms = now;
    uint8_t flags = static_cast<uint8_t>((g_eb_relay ? HF_EB_RELAY : 0) | HF_EB_PATH);
    if (g_silence_req_frames > 0) { flags |= g_silence_req; g_silence_req_frames = g_silence_req_frames - 1; }
    n = g_hub->buildHubFree(pl, sizeof(pl), flags, g_battery_mv, static_cast<uint16_t>(now / 60000UL), g_hub->frameNow());
  }
  if (n == 0) return;
  eb::Header h;
  h.net = g_net; h.sender = g_self; h.type = eb::MSG_EB_HUB; h.hops = 0; h.origin = g_self; h.seq = ++g_eb_seq;
  const size_t fl = eb::encode(h, pl, n, f, sizeof(f));
  if (fl > 0 && g_eb_send(f, fl)) g_eb_tx = g_eb_tx + 1;
}

const char* meshModeName(uint8_t mode) { return validMode(mode) ? modeInfo(static_cast<RadioMode>(mode)).name : "-"; }
const char* meshTestModeName(uint8_t m) {
  switch (m) {
    case TEST_OFF: return "off"; case TEST_ROTATE: return "rotate"; case TEST_FIX_SF9: return "SF9/500";
    case TEST_FIX_SF8: return "SF8/500"; case TEST_FIX_SF7: return "SF7/500"; default: return "?";
  }
}

String meshRadioJson() {
  String s;
  s.reserve(4500);
  s += "{\"role\":\""; s += g_chalet ? "chalet" : "hub"; s += "\"";
  s += ",\"radio_ok\":"; s += g_radio_ok ? "true" : "false";
  s += ",\"frame\":"; s += g_frame;
  s += ",\"rx_ok\":"; s += g_rx_ok; s += ",\"rx_crc\":"; s += g_rx_crc; s += ",\"tx\":"; s += g_tx;
  s += ",\"test_mode\":\""; s += meshTestModeName(meshTestMode()); s += "\"";
  s += ",\"adaptive\":"; s += g_cfg_adaptive ? "true" : "false";
  // network config + backbone
  static const char* const TR_NAMES[] = {"auto", "lora", "espnow", "ebfirst"};
  const uint8_t tr = meshTransport();
  s += ",\"transport\":\""; s += TR_NAMES[tr <= TR_PREFER_EB ? tr : 0]; s += "\"";
  {
    uint32_t arm_s;
    if (g_chalet) arm_s = chaletArmInS();
    else { Lock l; arm_s = g_pol.armInS(millis()); }
    s += ",\"setup\":"; s += arm_s ? "true" : "false"; s += ",\"arm_in_s\":"; s += arm_s;
  }
  s += ",\"channel\":"; s += g_lora_ch;
  s += ",\"channel_mhz\":"; s += String(loraChannelMHz(g_lora_ch), 1);
  s += ",\"eb\":{\"lr\":"; s += EB_LR ? "true" : "false";
  s += ",\"relay\":"; s += g_eb_relay ? "true" : "false";
  s += ",\"rx\":"; s += g_eb_rx; s += ",\"tx\":"; s += g_eb_tx;
  s += ",\"relayed\":"; s += g_eb_relayed; s += ",\"dup\":"; s += g_eb_dup; s += "}";
  if (g_ch != nullptr) {
    s += ",\"channel_setting\":"; s += g_cfg_channel == MESH_CH_AUTO ? String("\"auto\"") : String(g_cfg_channel);
    s += ",\"channel_moves\":"; s += g_ch_moves;
    s += ",\"channels\":[";
    for (uint8_t c = 0; c < LORA_CHANNELS; c++) {
      if (c) s += ",";
      s += "{\"ch\":"; s += c; s += ",\"mhz\":"; s += String(loraChannelMHz(c), 1);
      s += ",\"busy\":"; s += g_busy_pct[c] == 255 ? String("null") : String(g_busy_pct[c]); s += "}";
    }
    s += "]";
    // how each hub was last heard (LoRa slot / backbone), ages in s (-1 = never)
    HubPath paths[12];
    { Lock l; memcpy(paths, g_paths, sizeof(paths)); }
    const uint32_t now = millis();
    s += ",\"paths\":[";
    bool fp = true;
    for (uint8_t i = 0; i < 12; i++) {
      const HubPath& p = paths[i];
      if (p.id == 0) continue;
      if (!fp) s += ",";
      fp = false;
      s += "{\"id\":"; s += p.id;
      s += ",\"lora_age\":"; s += p.lora_ms ? static_cast<long>((now - p.lora_ms) / 1000) : -1L;
      s += ",\"eb_age\":"; s += p.eb_ms ? static_cast<long>((now - p.eb_ms) / 1000) : -1L;
      s += ",\"eb_hops\":"; s += p.hops;
      s += ",\"relay\":"; s += (p.flags & HF_EB_RELAY) ? "true" : "false";
      s += ",\"eb_path\":"; s += (p.flags & HF_EB_PATH) ? "true" : "false";
      s += "}";
    }
    s += "]";
  }
  if (g_ch != nullptr) {
    // copy under the lock, format outside it (keeps the radio task's timing unaffected)
    static HubInfo hubs[10];
    uint8_t nh = 0;
    uint8_t allowance; uint32_t dropped, bad, test_bytes;
    {
      Lock l;
      allowance = g_ch->planner.lastAllowance(); dropped = g_ch->planner.droppedSlots();
      bad = g_ch->bad_packets; test_bytes = g_ch->test_bytes_rx;
      for (uint8_t i = 0; i < g_ch->planner.capacity() && nh < 10; i++) {
        const HubInfo* h = g_ch->planner.hubAt(i);
        if (h != nullptr) hubs[nh++] = *h;
      }
    }
    s += ",\"allowance\":"; s += allowance;
    s += ",\"dropped_slots\":"; s += dropped;
    s += ",\"bad_packets\":"; s += bad;
    s += ",\"test_bytes\":"; s += test_bytes;
    s += ",\"hubs\":[";
    bool first = true;
    for (uint8_t i = 0; i < nh; i++) {
      const HubInfo* h = &hubs[i];
      if (!first) s += ",";
      first = false;
      s += "{\"id\":"; s += h->id; s += ",\"via\":"; s += h->via;
      s += ",\"mode\":\""; s += meshModeName(h->mode); s += "\"";
      s += ",\"rssi\":"; s += h->last_rssi; s += ",\"snr\":"; s += h->last_snr_q4 / 4.0f;
      s += ",\"modes\":[";
      for (uint8_t m = 0; m < MODE_COUNT; m++) {
        const ModeStats& st = h->stats[m];
        if (m) s += ",";
        s += "{\"mode\":\""; s += meshModeName(m); s += "\"";
        s += ",\"sched\":"; s += st.scheduled; s += ",\"rx\":"; s += st.received; s += ",\"crc\":"; s += st.crc_err;
        if (st.received) {
          s += ",\"rssi_avg\":"; s += static_cast<float>(st.rssi_sum) / st.received;
          s += ",\"rssi_min\":"; s += st.rssi_min; s += ",\"rssi_max\":"; s += st.rssi_max;
          s += ",\"snr_avg\":"; s += static_cast<float>(st.snr_q4_sum) / st.received / 4.0f;
          s += ",\"snr_min\":"; s += st.snr_min_q4 / 4.0f;
        }
        s += "}";
      }
      s += "]";
      if (h->has_health) {
        const Health& hl = h->health;
        s += ",\"health\":{\"battery_mv\":"; s += hl.battery_mv;
        s += ",\"uptime_min\":"; s += hl.uptime_min;
        s += ",\"beacon_rssi\":"; s += hl.beacon_rssi; s += ",\"beacon_snr\":"; s += hl.beacon_snr_q4 / 4.0f;
        s += ",\"beacon_lost64\":"; s += hl.beacon_lost; s += ",\"sync_err_us\":"; s += static_cast<int32_t>(hl.sync_err_10us) * 10;
        s += ",\"neighbors\":[";
        for (uint8_t k = 0; k < hl.n_nb; k++) {
          if (k) s += ",";
          s += "{\"hub\":"; s += hl.nb[k].hub; s += ",\"rssi\":"; s += hl.nb[k].rssi; s += "}";
        }
        s += "]}";
      }
      s += "}";
    }
    s += "]";
  }
  if (g_hub != nullptr) {
    MeshHubView v;
    meshHubView(v);
    s += ",\"synced\":"; s += v.synced ? "true" : "false";
    s += ",\"via_echo\":"; s += v.from_echo ? "true" : "false";
    s += ",\"beacon_rssi\":"; s += v.beacon_rssi; s += ",\"beacon_snr\":"; s += v.beacon_snr;
    s += ",\"lost64\":"; s += v.lost64; s += ",\"sync_err_us\":"; s += v.sync_err_us;
    s += ",\"slot_mode\":\""; s += v.own_slot_mode >= 0 ? meshModeName(static_cast<uint8_t>(v.own_slot_mode)) : "none"; s += "\"";
    s += ",\"allowance\":"; s += v.allowance;
    s += ",\"lora_on\":"; s += v.lora_on ? "true" : "false";
    s += ",\"eb_on\":"; s += v.eb_on ? "true" : "false";
    s += ",\"eb_fallback\":"; s += v.eb_fallback ? "true" : "false";
    s += ",\"eb_beacon_age\":"; s += v.eb_beacon_age_ms == 0xFFFFFFFFUL ? -1L : static_cast<long>(v.eb_beacon_age_ms / 1000);
  }
  s += "}";
  return s;
}

void meshPrintStatus(Print& out) {
  MeshCounters c;
  meshCounters(c);
  out.printf("[mesh] %s radio=%s frame=%u rx=%lu crc=%lu tx=%lu test=%s\n", g_chalet ? "chalet" : "hub",
             c.radio_ok ? "ok" : "ERR", c.frame, (unsigned long)c.rx_ok, (unsigned long)c.rx_crc,
             (unsigned long)c.tx, meshTestModeName(meshTestMode()));
  if (g_hub != nullptr) {
    MeshHubView v;
    meshHubView(v);
    out.printf("[mesh] synced=%d echo=%d beacon %d dBm SNR %.1f lost64=%u syncErr=%ld us slot=%s allow=%u\n",
               v.synced, v.from_echo, v.beacon_rssi, v.beacon_snr, v.lost64, (long)v.sync_err_us,
               v.own_slot_mode >= 0 ? meshModeName(static_cast<uint8_t>(v.own_slot_mode)) : "none", v.allowance);
  }
  if (g_ch != nullptr) {
    // copy under the lock, print after: Serial blocks (~1 ms per 10 chars) and must never
    // delay the radio task's beacon or slots
    static HubInfo hubs[10];
    uint8_t nh = 0;
    {
      Lock l;
      for (uint8_t i = 0; i < g_ch->planner.capacity() && nh < 10; i++) {
        const HubInfo* h = g_ch->planner.hubAt(i);
        if (h != nullptr) hubs[nh++] = *h;
      }
    }
    for (uint8_t i = 0; i < nh; i++) {
      const HubInfo* h = &hubs[i];
      out.printf("[mesh] hub %u via %u mode %s last %d dBm SNR %.1f |", h->id, h->via, meshModeName(h->mode),
                 h->last_rssi, h->last_snr_q4 / 4.0f);
      for (uint8_t m = 0; m < MODE_COUNT; m++) {
        const ModeStats& st = h->stats[m];
        out.printf(" %s %lu/%lu", meshModeName(m), (unsigned long)st.received, (unsigned long)st.scheduled);
        if (st.received) out.printf(" (%.0f dBm, SNR %.1f)", (float)st.rssi_sum / st.received, (float)st.snr_q4_sum / st.received / 4.0f);
      }
      out.println();
    }
  }
  out.printf("[mesh] late TX skipped: %lu\n", (unsigned long)g_tx_late_skips);
  static const char* const TR_NAMES[] = {"Auto", "LoRa only", "ESP-NOW only", "ESP-NOW first"};
  const uint8_t tr = meshTransport();
  {
    uint32_t arm_s;
    if (g_chalet) arm_s = chaletArmInS();
    else { Lock l; arm_s = g_pol.armInS(millis()); }
    if (arm_s) out.printf("[net] SETUP PHASE: automatic fallbacks arm in %lu s (network complete and stable for 5 min)\n", (unsigned long)arm_s);
    else out.println(F("[net] running: automatic fallbacks armed"));
  }
  out.printf("[net] transport %s | LoRa ch %u (%.1f MHz)%s | backbone rx %lu tx %lu relayed %lu dup %lu | relay %s\n",
             TR_NAMES[tr <= TR_PREFER_EB ? tr : 0], g_lora_ch, loraChannelMHz(g_lora_ch),
             g_chalet ? (g_cfg_channel == MESH_CH_AUTO ? " auto" : " fixed") : "",
             (unsigned long)g_eb_rx, (unsigned long)g_eb_tx, (unsigned long)g_eb_relayed, (unsigned long)g_eb_dup,
             g_eb_relay ? "ON" : "off");
  if (g_hub != nullptr) {
    MeshHubView v;
    meshHubView(v);
    out.printf("[net] hub sends on: %s%s%s | backbone beacon %s\n", v.lora_on ? "LoRa " : "", v.eb_on ? "ESP-NOW " : "",
               v.eb_fallback ? "(Auto fallback)" : "",
               v.eb_beacon_age_ms == 0xFFFFFFFFUL ? "never heard" : (String(v.eb_beacon_age_ms / 1000) + " s ago").c_str());
  }
  if (g_ch != nullptr) {
    out.print("[net] activity %:");
    for (uint8_t c = 0; c < LORA_CHANNELS; c++) {
      if (g_busy_pct[c] == 255) out.printf(" %.0f:-", loraChannelMHz(c));
      else out.printf(" %.0f:%u", loraChannelMHz(c), g_busy_pct[c]);
    }
    out.printf(" | moves %u\n[net] noise floor dBm:", g_ch_moves);
    for (uint8_t c = 0; c < LORA_CHANNELS; c++) { if (g_floor_x10[c] == 0) out.print(" -"); else out.printf(" %d", g_floor_x10[c] / 10); }
    out.println();
  }
}

uint8_t meshHubSummaries(MeshHubSummary* out, uint8_t max) {
  if (g_ch == nullptr) return 0;
  Lock l;
  uint8_t n = 0;
  for (uint8_t i = 0; i < g_ch->planner.capacity() && n < max; i++) {
    const HubInfo* h = g_ch->planner.hubAt(i);
    if (h == nullptr) continue;
    MeshHubSummary& o = out[n++];
    o.id = h->id; o.via = h->via; o.mode = h->mode; o.rssi = h->last_rssi; o.snr = h->last_snr_q4 / 4.0f;
    o.rx = 0; o.sched = 0;
    for (uint8_t m = 0; m < MODE_COUNT; m++) { o.rx += h->stats[m].received; o.sched += h->stats[m].scheduled; }
  }
  return n;
}

// ---------------------------------------------------------------------------------------------
// Sonar (test mode + FOCUS)
// ---------------------------------------------------------------------------------------------
uint8_t meshSonarVirtualId(uint8_t hub_id, uint8_t k) { return static_cast<uint8_t>(128 + (hub_id & 0x0F) * 8 + (k & 7)); }
void meshSetSonarSim(bool on) { g_cfg_sonar_sim = on; }

bool meshSonarSim() {
  if (g_chalet) return g_cfg_sonar_sim;
  if (g_hub == nullptr) return false;
  Lock l;
  return g_hub->sonarSim();
}

// D81 (5.4): the streamed holes: the watched one first, then up to two more (0 = none). Returns the count.
uint8_t meshFocusNodes(uint8_t* out) {
  uint8_t n = 0;
  if (g_chalet) {
    if (g_ch == nullptr) return 0;
    Lock l;
    return g_ch->streamedHoles(out);   // what this frame's beacon says (extras only while they fit)
  }
  if (g_hub == nullptr) return 0;
  Lock l;
  if (g_hub->focusNode()) out[n++] = g_hub->focusNode();
  for (uint8_t k = 0; k < 2; k++) if (g_hub->focusExtra(k)) out[n++] = g_hub->focusExtra(k);
  return n;
}
bool meshIsFocus(uint8_t node) {
  if (node == 0) return false;
  uint8_t f[3]; const uint8_t n = meshFocusNodes(f);
  for (uint8_t i = 0; i < n; i++) if (f[i] == node) return true;
  return false;
}
uint8_t meshFocusNode() {
  if (g_chalet) return g_cfg_focus;
  if (g_hub == nullptr) return 0;
  Lock l;
  return g_hub->focusNode();
}

bool meshHubPushSonar(const uint8_t* blk, uint8_t len) {
  if (g_hub == nullptr) return false;
  Lock l;
  return g_hub->sonar.push(blk, len, g_hub->frameNow());   // frame from the beacon or the backbone beacon
}

String meshSonarListJson() {
  String s;
  s.reserve(400 + 16 * 160);
  s = "{\"sim\":"; s += g_cfg_sonar_sim ? "true" : "false";
  s += ",\"focus\":"; s += g_cfg_focus;
  { uint8_t f[3]; const uint8_t n = meshFocusNodes(f); s += ",\"live\":[";   // D81: every streamed hole (the beacon's view)
    for (uint8_t i = 0; i < n; i++) { if (i) s += ","; s += f[i]; } s += "]"; }
  s += ",\"frame\":"; s += g_frame;
  { const uint32_t now = millis();   // D80 follow the action
    s += ",\"follow\":"; s += g_follow.on ? "true" : "false"; s += ",\"follow_n\":"; s += g_follow.max_extra + 1;
    s += ",\"why\":\""; s += g_follow.why; s += "\"";
    s += ",\"pin_s\":"; s += g_follow.pinLeftMs(now) / 1000; s += ",\"trip_s\":"; s += g_follow.tripLeftMs(now) / 1000; }
  s += ",\"nodes\":[";
  if (g_sonar != nullptr) {
    static sonar::NodeSonar copy[16];
    uint8_t n = 0;
    uint32_t ok = 0, bad = 0;
    {
      Lock l;
      for (uint8_t i = 0; i < g_sonar->capacity() && n < 16; i++) {
        const sonar::NodeSonar* ns = g_sonar->at(i);
        if (ns != nullptr) copy[n++] = *ns;
      }
      ok = g_sonar->blocks_ok; bad = g_sonar->blocks_bad;
    }
    for (uint8_t i = 0; i < n; i++) {
      const sonar::NodeSonar& ns = copy[i];
      char b[240];
      snprintf(b, sizeof(b),
               "%s{\"node\":%u,\"hub\":%u,\"age\":%d,\"ping\":%u,\"bottom\":%u,\"hard\":%u,\"fish\":%u,\"near\":%u,\"lvl\":%u,\"act\":%u,\"bgver\":%u,\"bgmask\":%u,\"sum\":%s,\"st\":%u,\"bsnr\":%u}",
               i ? "," : "", ns.node, ns.hub, static_cast<int>(frameAgeS(ns.frame)), ns.sum.ping,
               ns.sum.bottom_cm, ns.sum.hard, ns.sum.n_targets, ns.sum.nearest_cm, ns.sum.nearest_level, ns.sum.activity,
               ns.bg_ver, ns.bg_mask, ns.has_sum ? "true" : "false", ns.sum.status, ns.sum.bottom_snr);
      s += b;
    }
    s += "],\"blocks_ok\":"; s += ok; s += ",\"blocks_bad\":"; s += bad;
    s += "}";
    return s;
  }
  s += "]}";
  return s;
}

// {"node":N,"last":seq,"pings":[[seq,index,bottom,[[track,depth,strength,width],..],[[bin,level],..],hard,nf_neg,
//                                 [[track,flick_q,spread_q,elen,mature],..]],..]}   (see sonar_codec.h for units)
// D93: the echogram lines of `node` newer than `since` as [seq, index, nf_neg, "122 hex nibbles"] (newest `max` of them)
static void appendEchoJson(String& s, uint8_t node, uint32_t since, uint8_t max) {
  static sonar::StoredEcho copy[16];
  uint16_t n = 0; uint32_t last = 0;
  if (max > 16) max = 16;
  {
    Lock l;
    const sonar::StoredEcho* ptr[48];
    n = g_sonar->echoSince(node, since, ptr, 48);
    const uint16_t skip = n > max ? static_cast<uint16_t>(n - max) : 0;
    for (uint16_t i = skip; i < n; i++) copy[i - skip] = *ptr[i];
    n = static_cast<uint16_t>(n - skip);
    last = g_sonar->lastEchoSeq();
  }
  s += ",\"elast\":"; s += last; s += ",\"echo\":[";
  static const char H[] = "0123456789ABCDEF";
  for (uint16_t i = 0; i < n; i++) {
    char b[40]; snprintf(b, sizeof(b), "%s[%lu,%u,%u,\"", i ? "," : "", static_cast<unsigned long>(copy[i].seq), copy[i].e.index, copy[i].e.nf_neg);
    s += b;
    char cells[sonar::ECHO_CELLS + 1];
    for (uint8_t c = 0; c < sonar::ECHO_CELLS; c++) cells[c] = H[sonar::echoCell(copy[i].e, c)];
    cells[sonar::ECHO_CELLS] = 0;
    s += cells; s += "\","; s += copy[i].e.scale; s += ","; s += copy[i].e.sharp; s += ","; s += copy[i].e.marks; s += ","; s += copy[i].e.fine; s += "]";   // D112 / D126 / D133: [seq, index, nf, cells, scale, sharpened, marks] (marks: cells = the payload, 2 nibbles per byte, low first)
  }
  s += "]";
}

String meshSonarPingsJson(uint8_t node, uint32_t since, uint8_t max_pings, bool lite, bool with_echo, uint32_t echo_since) {
  String s;
  if (g_sonar == nullptr) return F("{\"pings\":[]}");
  if (max_pings > 64) max_pings = 64;
  static sonar::StoredPing copy[64];
  uint16_t n = 0;
  uint32_t last;
  {
    Lock l;
    const sonar::StoredPing* ptr[128];   // review: the whole ring, so the NEWEST max_pings are returned (not the newest of the oldest 64)
    n = g_sonar->pingsSince(node, since, ptr, 128);
    const uint16_t skip = n > max_pings ? static_cast<uint16_t>(n - max_pings) : 0;   // newest ones
    for (uint16_t i = skip; i < n; i++) copy[i - skip] = *ptr[i];
    n = static_cast<uint16_t>(n - skip);
    last = g_sonar->lastSeq();
  }
  s.reserve(80 + n * (lite ? 130 : 260) + (with_echo ? 16 * 150 : 0));
  s = "{\"node\":"; s += node; s += ",\"last\":"; s += last; s += ",\"pings\":[";
  for (uint16_t i = 0; i < n; i++) {
    const sonar::Ping& p = copy[i].p;
    char b[64];
    snprintf(b, sizeof(b), "%s[%lu,%u,%u,[", i ? "," : "", static_cast<unsigned long>(copy[i].seq), p.index, p.bottom_cm);
    s += b;
    for (uint8_t k = 0; k < p.n_targets; k++) {
      snprintf(b, sizeof(b), "%s[%u,%u,%u,%u]", k ? "," : "", p.t[k].track, p.t[k].depth_cm, p.t[k].strength, p.t[k].width);
      s += b;
    }
    s += "],[";
    for (uint8_t k = 0; k < (lite ? 0 : p.n_resid); k++) {
      snprintf(b, sizeof(b), "%s[%u,%u]", k ? "," : "", p.r[k].bin, p.r[k].level);
      s += b;
    }
    snprintf(b, sizeof(b), "],%u,%u,[", copy[i].hard, copy[i].nf_neg);
    s += b;
    for (uint8_t k = 0; k < (lite ? 0 : copy[i].n_info); k++) {
      const sonar::TrackInfo& x = copy[i].info[k];
      snprintf(b, sizeof(b), "%s[%u,%u,%u,%u,%u]", k ? "," : "", x.track, x.flick_q, x.spread_q, x.elen, x.mature ? 1 : 0);
      s += b;
    }
    s += "]]";
  }
  s += "]";
  if (with_echo) appendEchoJson(s, node, echo_since, 16);   // D93
  s += "}";
  return s;
}

String meshSonarBgJson(uint8_t node) {
  if (g_sonar == nullptr) return F("{}");
  static uint8_t lv[sonar::BINS];
  uint8_t ver = 0, mask = 0;
  bool found = false;
  {
    Lock l;
    const sonar::NodeSonar* ns = g_sonar->find(node);
    if (ns != nullptr) { memcpy(lv, ns->bg, sizeof(lv)); ver = ns->bg_ver; mask = ns->bg_mask; found = true; }
  }
  String s;
  s.reserve(560);
  s = "{\"node\":"; s += node; s += ",\"ver\":"; s += ver; s += ",\"mask\":"; s += mask;
  s += ",\"bin_mm\":"; s += sonar::BIN_MM; s += ",\"levels\":\"";
  if (found) for (uint16_t i = 0; i < sonar::BINS; i++) s += static_cast<char>('0' + (lv[i] & 3));
  s += "\"}";
  return s;
}

// Per-hole sonar history for the "at a glance" views: summaries newer than `since` (frame number,
// 0 = everything kept, ~2 min). {"frame":F,"nodes":[{"node":n,"hub":h,"hard":x,"act":a,
//   "recs":[[frame,bottom_cm,t,..],..]}]} with t = depth_cm | level << 11 | bait << 13 (sonar_link.h).
String meshSonarGlanceJson(uint16_t since) {
  if (g_sonar == nullptr) return F("{\"frame\":0,\"nodes\":[]}");
  static sonar::BaseRec recs[SONAR_HIST];
  uint8_t ids[16], hubs[16], hards[16], acts[16]; uint8_t nn = 0;
  {
    Lock l;
    for (uint8_t i = 0; i < g_sonar->capacity() && nn < 16; i++) {
      const sonar::NodeSonar* ns = g_sonar->at(i);
      if (ns == nullptr) continue;
      ids[nn] = ns->node; hubs[nn] = ns->hub; hards[nn] = ns->sum.hard; acts[nn] = ns->sum.activity; nn++;
    }
  }
  // D84: a first load (since = 0) sends the last 45 summaries per hole (1.5 min at one per 2 s), not 90: a 12-hole
  // demo was a 27 KB String on a heap that also holds three fake sonars; the page tops up every 2 s anyway
  const uint8_t per = since ? SONAR_HIST : 45;
  String s;
  s.reserve(256 + nn * (since ? 200 : 1100));
  s = "{\"frame\":"; s += g_frame; s += ",\"nodes\":[";
  for (uint8_t k = 0; k < nn; k++) {
    uint8_t n;
    { Lock l; n = g_sonar->history(ids[k], recs, SONAR_HIST); }
    const uint8_t r0 = n > per ? static_cast<uint8_t>(n - per) : 0;
    if (k) s += ",";
    s += "{\"node\":"; s += ids[k]; s += ",\"hub\":"; s += hubs[k]; s += ",\"hard\":"; s += hards[k];
    s += ",\"act\":"; s += acts[k]; s += ",\"recs\":[";
    bool first = true;
    for (uint8_t r = r0; r < n; r++) {
      if (since != 0 && seqDiff(recs[r].frame, since) <= 0) continue;
      if (!first) s += ",";
      first = false;
      s += "["; s += recs[r].frame; s += ","; s += recs[r].bottom_cm;
      for (uint8_t t = 0; t < recs[r].n; t++) { s += ","; s += recs[r].t[t]; }
      s += "]";
    }
    s += "]}";
  }
  s += "]}";
  return s;
}

uint8_t meshSonarHistory(uint8_t node, MeshBaseRec* out, uint8_t max) {
  if (g_sonar == nullptr) return 0;
  static sonar::BaseRec r[90];
  if (max > 90) max = 90;
  uint8_t n;
  { Lock l; n = g_sonar->history(node, r, max); }
  for (uint8_t k = 0; k < n; k++) {
    out[k].frame = r[k].frame; out[k].bottom_cm = r[k].bottom_cm; out[k].n = r[k].n;
    for (uint8_t j = 0; j < 5; j++) out[k].t[j] = j < r[k].n ? r[k].t[j] : 0;
  }
  return n;
}

// ---- raw views for the OLED screens ----
bool meshSonarSummary(uint8_t node, MeshSonarLite& out) {
  if (g_sonar == nullptr) return false;
  Lock l;
  const sonar::NodeSonar* ns = g_sonar->find(node);
  if (ns == nullptr || !ns->has_sum) return false;
  out.bottom_cm = ns->sum.bottom_cm >= sonar::DEPTH_NONE ? 0 : ns->sum.bottom_cm;
  out.hard = ns->sum.hard; out.activity = ns->sum.activity; out.n = ns->sum.n_list;
  out.status = ns->sum.status; out.bottom_snr = ns->sum.bottom_snr;
  for (uint8_t k = 0; k < out.n && k < 5; k++) out.t[k] = sonar::packTarget(ns->sum.list[k]);
  out.age_frames = static_cast<uint16_t>(g_frame - ns->frame); out.age_s = frameAgeS(ns->frame);
  return true;
}

uint8_t meshFocusPings(uint8_t node, MeshPingLite* out, uint8_t max) {
  if (g_sonar == nullptr || max == 0) return 0;
  Lock l;
  static const sonar::StoredPing* ptr[128];
  const uint16_t n = g_sonar->pingsSince(node, 0, ptr, 128);
  const uint16_t skip = n > max ? static_cast<uint16_t>(n - max) : 0;
  uint8_t k = 0;
  for (uint16_t i = skip; i < n; i++, k++) {
    const sonar::Ping& p = ptr[i]->p;
    MeshPingLite& o = out[k];
    o.bottom_cm = p.bottom_cm >= sonar::DEPTH_NONE ? 0 : p.bottom_cm;
    o.n = 0; o.bait_mask = 0;
    for (uint8_t t = 0; t < p.n_targets && o.n < 5; t++) {
      o.d[o.n] = p.t[t].depth_cm; o.lv[o.n] = p.t[t].level ? p.t[t].level : 1;
      if (p.t[t].track == 0) o.bait_mask = static_cast<uint8_t>(o.bait_mask | (1u << o.n));
      o.n++;
    }
  }
  return k;
}

uint8_t meshHubLinks(MeshHubLink* out, uint8_t max) {
  if (g_ch == nullptr) return 0;
  Lock l;
  const uint32_t now = millis();
  uint8_t n = 0;
  for (uint8_t i = 0; i < 12 && n < max; i++) {
    const HubPath& p = g_paths[i];
    if (p.id == 0) continue;
    MeshHubLink& o = out[n++];
    o.id = p.id; o.hops = p.hops; o.demo = p.demo;
    o.lora_age_s = p.lora_ms ? static_cast<int32_t>((now - p.lora_ms) / 1000) : -1;
    o.eb_age_s = p.eb_ms ? static_cast<int32_t>((now - p.eb_ms) / 1000) : -1;
    const HubInfo* h = g_ch->planner.find(p.id);
    o.rssi = h != nullptr ? h->last_rssi : 0;
  }
  return n;
}

// =============================================================================================
// v2 DEMO NETWORK (chalet only, no other hardware) - docs/SONAR_SIM.md "Demo network"
// Up to 4 fake hubs with 1-4 holes each run inside the chalet. Each one is a real HubRole: its line
// table, sonar outbox and hub packet are the ones a real hub uses; the packet goes into the chalet
// through the backbone entry (onEbHubPacket) and the chalet's backbone beacon is fed back to it (acks,
// focus, CMD_SET_SIM). Fake sonar: a light BASE summary every 2 s per hole, and the full fake fish
// finder (SonarSource, ~15 KB, one only) for the FOCUS hole. Fake Hall trips per hole when asked.
// IDs (keep them free in a real network): hubs 121-124, their own hole = hub ID, other holes 101-112
// (never produced by meshSonarVirtualId, 128-255). Not saved: off after every reboot.
// Threads: the demo state is used from loop() only; the lock is taken only around the chalet objects
// (g_ch, g_paths), never around the fake sonar work, so the radio task keeps its timing.
// =============================================================================================
static const uint8_t DEMO_HUB0 = 121, DEMO_MAX_HUBS = 4, DEMO_MAX_HOLES = 4;
struct DemoHole {
  uint8_t id, sim, batt, nf, act_bits;
  bool tripped;
  uint32_t until_ms, next_ms;
  uint16_t bottom_cm, bait_cm, ping;
  uint16_t fd[3]; uint8_t fl[3];   // fake fish: depth, level (0 = none)
};
struct DemoHub { HubRole<8>* role; DemoHole holes[DEMO_MAX_HOLES]; };
static DemoHub g_demo[DEMO_MAX_HUBS];
static uint8_t g_demo_hubs = 0, g_demo_holes = 3;
static sonar::SonarSource* g_demo_src = nullptr;   // full fake sonar of the FOCUS hole
static sonar::SonarSource* g_demo_xsrc[2] = {nullptr, nullptr}; static uint8_t g_demo_xnode[2] = {0, 0};   // D82: the extra streamed holes
static sonar::Params g_demo_prm;                   // the chalet's sonar knobs, applied to the demo FOCUS sonar
static uint8_t g_demo_src_node = 0;
static uint32_t g_demo_rng = 0x1234567u;

static uint32_t demoRand() { g_demo_rng ^= g_demo_rng << 13; g_demo_rng ^= g_demo_rng >> 17; g_demo_rng ^= g_demo_rng << 5; return g_demo_rng; }

// Other holes 101-112: below 128, so never an ID a real hub gives its test holes (meshSonarVirtualId: 128-255)
static uint8_t demoHoleId(uint8_t hub, uint8_t k) {
  return k == 0 ? hub : static_cast<uint8_t>(101 + (hub - DEMO_HUB0) * 3 + (k - 1));
}

bool meshDemoNode(uint8_t id) {
  for (uint8_t h = 0; h < DEMO_MAX_HUBS; h++)
    for (uint8_t k = 0; k < DEMO_MAX_HOLES; k++) if (demoHoleId(static_cast<uint8_t>(DEMO_HUB0 + h), k) == id) return true;
  return false;
}

static DemoHole* demoHole(uint8_t id) {
  for (uint8_t h = 0; h < g_demo_hubs; h++)
    for (uint8_t k = 0; k < g_demo_holes; k++) if (g_demo[h].holes[k].id == id) return &g_demo[h].holes[k];
  return nullptr;
}

uint8_t meshDemoHubs() { return g_demo_hubs; }
void meshDemoSetParams(const uint8_t* v, uint8_t n) {
  for (uint8_t i = 0; i < n && i < sonar::P_COUNT; i++) g_demo_prm.v[i] = v[i];
  if (g_demo_src != nullptr) g_demo_src->proc.prm = g_demo_prm;
  for (uint8_t k = 0; k < 2; k++) if (g_demo_xsrc[k] != nullptr) g_demo_xsrc[k]->proc.prm = g_demo_prm;
}
uint8_t meshDemoHoles() { return g_demo_holes; }

uint8_t meshDemoSim(uint8_t id) {
  const DemoHole* d = demoHole(id);
  return d ? d->sim : 0xFF;
}

void meshDemoName(uint8_t id, char* out, size_t n) {   // "Demo A1": pocket letter, hole number
  for (uint8_t h = 0; h < DEMO_MAX_HUBS; h++)
    for (uint8_t k = 0; k < DEMO_MAX_HOLES; k++)
      if (demoHoleId(static_cast<uint8_t>(DEMO_HUB0 + h), k) == id) { snprintf(out, n, "Demo %c%u", 'A' + h, k + 1); return; }
  if (n) out[0] = 0;
}

static void demoApplySim(uint8_t target, uint8_t value) {
  for (uint8_t h = 0; h < g_demo_hubs; h++)
    for (uint8_t k = 0; k < g_demo_holes; k++) {
      DemoHole& d = g_demo[h].holes[k];
      if (target != 255 && target != d.id) continue;
      d.sim = value; d.tripped = false; d.next_ms = 0;
    }
}

void meshDemoSetSim(uint8_t id, uint8_t value) { demoApplySim(id, value); }

void meshDemoSetBait(uint8_t id, uint8_t v5) {   // demo hole: bait depth (5 cm steps, 0 = keep)
  DemoHole* d = demoHole(id);
  if (d == nullptr || v5 == 0) return;
  uint16_t cm = static_cast<uint16_t>(v5 * 5u);
  if (cm + 20 > d->bottom_cm) cm = static_cast<uint16_t>(d->bottom_cm - 20);
  d->bait_cm = cm;
  if (g_demo_src != nullptr && g_demo_src_node == id) { g_demo_src->proc.bait_m = cm / 100.0f; g_demo_src->scene.setBait(cm / 100.0f); }
  for (uint8_t k = 0; k < 2; k++) if (g_demo_xsrc[k] != nullptr && g_demo_xnode[k] == id) { g_demo_xsrc[k]->proc.bait_m = cm / 100.0f; g_demo_xsrc[k]->scene.setBait(cm / 100.0f); }
}

void meshDemoSet(uint8_t hubs, uint8_t holes) {
  if (!g_chalet || g_ch == nullptr) return;
  if (hubs > DEMO_MAX_HUBS) hubs = DEMO_MAX_HUBS;
  if (holes < 1) holes = 1;
  if (holes > DEMO_MAX_HOLES) holes = DEMO_MAX_HOLES;
  if (hubs == g_demo_hubs && holes == g_demo_holes) return;
  {
    Lock l;   // forget what is not in the new layout (holes and hubs), so the pages do not keep offline ghosts
    for (uint8_t h = 0; h < DEMO_MAX_HUBS; h++)
      for (uint8_t k = 0; k < DEMO_MAX_HOLES; k++)
        if (h >= hubs || k >= holes) g_ch->nodes.forget(demoHoleId(static_cast<uint8_t>(DEMO_HUB0 + h), k));
    for (uint8_t i = 0; i < 12; i++) if (g_paths[i].demo && g_paths[i].id >= DEMO_HUB0 + hubs) memset(&g_paths[i], 0, sizeof(g_paths[i]));
  }
  g_demo_rng ^= millis();
  for (uint8_t h = 0; h < DEMO_MAX_HUBS; h++) {
    DemoHub& d = g_demo[h];
    const uint8_t hub_id = static_cast<uint8_t>(DEMO_HUB0 + h);
    if (h < hubs && d.role == nullptr) {
      d.role = new HubRole<8>();
      d.role->network_id = g_net; d.role->self = hub_id;
    }
    if (h < hubs) {
      d.role->table = LineTable<8>();   // fresh table for the new layout
      for (uint8_t k = 0; k < DEMO_MAX_HOLES; k++) {
        DemoHole& o = d.holes[k];
        const bool keep = o.id == demoHoleId(hub_id, k) && k < g_demo_holes && h < g_demo_hubs;
        if (!keep) {
          memset(&o, 0, sizeof(o));
          o.id = demoHoleId(hub_id, k);
          o.sim = MESH_SIM_SONAR;                                       // fake sonar on, fake trips off
          o.batt = static_cast<uint8_t>(55 + demoRand() % 45);
          o.bottom_cm = static_cast<uint16_t>(350 + demoRand() % 650);  // 3.5-10 m
          o.bait_cm = static_cast<uint16_t>(o.bottom_cm - 40 - demoRand() % 80);
        }
      }
    }
  }
  g_demo_hubs = hubs; g_demo_holes = holes;
  if (hubs == 0 && g_demo_src != nullptr) { delete g_demo_src; g_demo_src = nullptr; g_demo_src_node = 0; }
  if (hubs == 0) for (uint8_t k = 0; k < 2; k++) if (g_demo_xsrc[k] != nullptr) { delete g_demo_xsrc[k]; g_demo_xsrc[k] = nullptr; g_demo_xnode[k] = 0; }
}

// light fake sonar: bottom, bait and 0-3 fish wandering, as one BASE block (what a non-focus hole sends)
static void demoSummary(DemoHole& d, HubRole<8>& role) {
  for (uint8_t i = 0; i < 3; i++) {
    if (d.fl[i] == 0) {
      if (demoRand() % 100 < 12) {   // a fish comes in
        d.fd[i] = static_cast<uint16_t>(100 + demoRand() % (d.bottom_cm > 160 ? d.bottom_cm - 120 : 40));
        d.fl[i] = static_cast<uint8_t>(1 + demoRand() % 3);
      }
    } else {
      const int step = static_cast<int>(demoRand() % 31) - 15;
      int nd = static_cast<int>(d.fd[i]) + step;
      if (nd < 60) nd = 60;
      if (nd > d.bottom_cm - 15) nd = d.bottom_cm - 15;
      d.fd[i] = static_cast<uint16_t>(nd);
      if (demoRand() % 100 < 10) d.fl[i] = 0;   // it leaves
    }
  }
  sonar::Summary s;
  memset(&s, 0, sizeof(s));
  d.ping = static_cast<uint16_t>(d.ping + 8);
  s.node = d.id; s.ping = d.ping; s.hard = sonar::BH_MEDIUM;
  s.bottom_cm = static_cast<uint16_t>(d.bottom_cm + demoRand() % 5 - 2);
  s.list[s.n_list].track = 0; s.list[s.n_list].depth_cm = d.bait_cm; s.list[s.n_list].level = 2; s.n_list++;
  uint8_t fish = 0;
  for (uint8_t i = 0; i < 3; i++) {
    if (d.fl[i] == 0 || s.n_list >= sonar::MAX_TARGETS) continue;
    s.list[s.n_list].track = 1; s.list[s.n_list].depth_cm = d.fd[i]; s.list[s.n_list].level = d.fl[i]; s.n_list++;
    fish++;
  }
  s.n_targets = fish;
  // D43 flags and level check, like a real hole: fish within 40 cm of the bait, bait within 30 cm of the bottom
  for (uint8_t i = 0; i < 3; i++) if (d.fl[i] && (d.fd[i] > d.bait_cm ? d.fd[i] - d.bait_cm : d.bait_cm - d.fd[i]) < 40) s.status |= sonar::ST_NEAR_BAIT;
  if (d.bottom_cm < d.bait_cm + 30) s.status |= sonar::ST_BAIT_COVER;
  s.bottom_snr = static_cast<uint8_t>(30 + (d.id * 7) % 25);
  d.act_bits = static_cast<uint8_t>((d.act_bits << 1) | (fish ? 1 : 0));
  uint8_t a = 0; for (uint8_t b = d.act_bits; b; b >>= 1) a = static_cast<uint8_t>(a + (b & 1));
  s.activity = static_cast<uint8_t>(a * 2 > 15 ? 15 : a * 2);
  sonar::summaryNearest(s);
  uint8_t blk[sonar::MAX_BLOCK];
  const size_t len = sonar::encodeSummary(s, blk, sizeof(blk));
  if (len > 0) role.sonar.push(blk, static_cast<uint8_t>(len), role.frameNow());
}

static bool demoTripped(DemoHole& d, uint32_t now) {
  if (!(d.sim & MESH_SIM_HALL)) { d.tripped = false; return false; }
  const uint32_t mean = 3600000UL / ((d.sim >> 2) ? (d.sim >> 2) : 6);
  if (d.tripped && static_cast<int32_t>(now - d.until_ms) >= 0) { d.tripped = false; d.next_ms = 0; }
  if (!d.tripped) {
    if (d.next_ms == 0) { d.next_ms = now + mean / 2 + demoRand() % (mean + 1); if (d.next_ms == 0) d.next_ms = 1; }
    if (static_cast<int32_t>(now - d.next_ms) >= 0) { d.tripped = true; d.until_ms = now + 20000UL + demoRand() % 70001UL; }
  }
  return d.tripped;
}

// chalet loop(): 4 times a second at most. Packets every 500 ms, BASE every 2 s, focus pings 4/s.
void meshDemoTick() {
  if (g_demo_hubs == 0 || g_ch == nullptr) return;
  static uint32_t last_ms = 0, last_pkt = 0, last_base = 0;
  static uint8_t eb[MAX_PACKET], pl[MAX_PACKET];
  const uint32_t now = millis();
  if (now - last_ms < 250) return;
  last_ms = now;
  // 1. the chalet beacon, as the hubs get it on the backbone: acks, focus, commands
  size_t bl; uint8_t focus; uint8_t xf[2];
  { Lock l; bl = g_ch->buildEbBeacon(eb, sizeof(eb)); focus = g_ch->focus_node; xf[0] = g_ch->beacon.focus_extra[0]; xf[1] = g_ch->beacon.focus_extra[1]; }
  for (uint8_t h = 0; h < g_demo_hubs; h++) {
    HubRole<8>& r = *g_demo[h].role;
    uint8_t cmd = CMD_NONE;
    if (bl > 0 && r.onEbBeacon(eb, bl, cmd) && cmd == CMD_SET_SIM) demoApplySim(r.last_cmd_target, r.last_cmd_value);
  }
  // 2. focus hole: the full fake fish finder (4 pings/s)
  DemoHole* fd = demoHole(focus);
  if (fd != nullptr && (fd->sim & MESH_SIM_SONAR)) {
    if (g_demo_src == nullptr) { g_demo_src = new (std::nothrow) sonar::SonarSource(); if (g_demo_src == nullptr) return; g_demo_src->proc.prm = g_demo_prm; }
    if (g_demo_src_node != focus) {
      g_demo_src->begin(focus, 7919UL * focus + 17UL, static_cast<uint16_t>(demoRand())); g_demo_src_node = focus;
      g_demo_src->proc.bait_m = fd->bait_cm / 100.0f; g_demo_src->scene.setBait(fd->bait_cm / 100.0f);   // this hole's bait
    }
    sonar::Block out[2];
    const uint8_t n = g_demo_src->tick(true, out, 2);
    for (uint8_t h = 0; h < g_demo_hubs; h++)
      for (uint8_t k = 0; k < g_demo_holes; k++)
        if (g_demo[h].holes[k].id == focus)
          for (uint8_t i = 0; i < n; i++) g_demo[h].role->sonar.push(out[i].data, out[i].len, g_demo[h].role->frameNow());
  }
  // 2b. D82: the extra streamed holes (what the beacon says), each with its own fake fish finder
  bool xlive[2] = {false, false};   // D84: an extra the heap could not afford keeps its 2 s summaries instead
  for (uint8_t x = 0; x < 2; x++) {
    const uint8_t id = xf[x];
    DemoHole* xd = id ? demoHole(id) : nullptr;
    if (xd == nullptr || !(xd->sim & MESH_SIM_SONAR) || id == focus) { g_demo_xnode[x] = 0; continue; }
    if (g_demo_xsrc[x] == nullptr) {   // D84: ~18 KB each; only when the heap can take it (the web server needs ~30 KB of room)
      if (ESP.getFreeHeap() < 70000UL || heap_caps_get_largest_free_block(MALLOC_CAP_8BIT) < 24000UL) { g_demo_xnode[x] = 0; continue; }
      g_demo_xsrc[x] = new (std::nothrow) sonar::SonarSource(); if (g_demo_xsrc[x] == nullptr) { g_demo_xnode[x] = 0; continue; }
      g_demo_xsrc[x]->proc.prm = g_demo_prm;
    }
    xlive[x] = true;
    if (g_demo_xnode[x] != id) {
      g_demo_xsrc[x]->begin(id, 7919UL * id + 31UL, static_cast<uint16_t>(demoRand())); g_demo_xnode[x] = id;
      g_demo_xsrc[x]->proc.bait_m = xd->bait_cm / 100.0f; g_demo_xsrc[x]->scene.setBait(xd->bait_cm / 100.0f);
    }
    sonar::Block out[2];
    const uint8_t n = g_demo_xsrc[x]->tick(true, out, 2);
    for (uint8_t h = 0; h < g_demo_hubs; h++)
      for (uint8_t k = 0; k < g_demo_holes; k++)
        if (g_demo[h].holes[k].id == id)
          for (uint8_t i = 0; i < n; i++) g_demo[h].role->sonar.push(out[i].data, out[i].len, g_demo[h].role->frameNow());
  }
  const bool base = now - last_base >= 2000;
  if (base) last_base = now;
  if (now - last_pkt < 500) return;
  last_pkt = now;
  // 3. each hub: line states, BASE sonar, packet -> chalet
  for (uint8_t h = 0; h < g_demo_hubs; h++) {
    DemoHub& d = g_demo[h];
    HubRole<8>& r = *d.role;
    for (uint8_t k = 0; k < g_demo_holes; k++) {
      DemoHole& o = d.holes[k];
      const uint8_t st = demoTripped(o, now) ? MESH_LS_TRIPPED : MESH_LS_IDLE;
      r.table.observe(o.id, st, 0, MESH_LF_SIM, o.batt, now);
      if (base && (o.sim & MESH_SIM_SONAR) && o.id != focus && !(xlive[0] && o.id == xf[0]) && !(xlive[1] && o.id == xf[1])) demoSummary(o, r);
    }
    const size_t n = r.buildHubFree(pl, sizeof(pl), 0, 3900, static_cast<uint16_t>(now / 60000UL), r.frameNow());
    if (n == 0) continue;
    Lock l;
    ChaletRxResult res;
    if (g_ch->onEbHubPacket(pl, n, 0, res)) chaletHandle(res, true, 0);
    for (uint8_t i = 0; i < 12; i++) if (g_paths[i].id == r.self) g_paths[i].demo = true;
  }
}
