frosted123456/Fishing_system_v2/(commit log)

2026-10-05 docs: record decisions D1-D7 and revised phase 1 plan
    PlatformIO, core 2.0.17, flag-day reflash, SF9 with SF7 fallback, no ACK on
    aggregates, cabin does not relay, library pins. Adds SF9 stream budget.
    Claude-Session: https://claude.ai/code/session_01A1NVA5jA7T8fBrAYk7aqhB
2026-10-05 build: migrate to a PlatformIO project (no behaviour change)
    - lora_node.ino -> src/lora_node/main.cpp, sensor_node.ino -> src/sensor_node/main.cpp
    Only changes: #include <Arduino.h>, the 6 prototypes the Arduino IDE used
    to generate (loRaChannelBusy, updateAlertState, handleWebApiNodeName,
    handleWebApiSilence, handleResetAllConfirmInput, sendResetAllCommand), and
    #ifndef guards so NODE_ID / NODE_NAME / NODE_ROLE / HAS_LOCAL_SENSOR / BOARD_*
    can come from build_flags.
    - messages.h: single copy in include/ (the two copies were byte-identical).
    - platformio.ini: espressif32 @ 7.0.1 (Arduino core 2.0.17), RadioLib 7.7.1,
    U8g2 2.36.18, ArduinoJson 6.21.6; envs hub, cabin, relay, sens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
2026-10-05 fix(lora): aggregate relay dedup keyed by origin hub (issue 1)
    Old key (network_id, network_id<<8 | lora_sequence) was identical for every hub,
    so a hub refused to relay another hub's aggregate whenever their 8-bit counters
    matched (they advance almost in lockstep). Now:
    - relays keep sender_id, so it stays the origin hub after any number of hops;
    - key = (origin hub, lora_sequence) in a dedicated 32-entry cache (30 s window),
    so aggregates no longer share the alert ring;
    - an echo of our own aggregate (sender_id == NODE_ID) is dropped on receive;
    - the origin hub's RSSI is only updated when heard directly (hop_count == 0).
    v1 wire format unchanged. Not compiled yet (toolchain download blo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
    [main.cpp]
2026-10-05 test: host test harness (pio test -e native + plain g++ Makefile)
    - lib/IceMesh skeleton (library.json, umbrella header), pure C++11
    - test/shim/unity.h: Unity-compatible shim so the same tests run with g++
    - test/Makefile: -std=c++11 -pedantic -Werror (ESP32 core 2.0.17 is gnu++11)
    - test/test_smoke: proves the harness; failure path checked (exit code 1)
    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
2026-10-05 feat(mesh): v2 header encode/decode + serial-number helpers
    lib/IceMesh/src/mesh_hdr.h: 8-byte header per protocol_v2.md §2 (ver byte 0xF2,
    class/hops/ack_req in ctl, origin never rewritten, prepareRelay() bumps hops and
    sets sender in place, LINK class never relayed, hop limit 3).
    lib/IceMesh/src/seq.h: seqDiff/seqNewer (16-bit wrap) and timeReached (millis wrap).
    9 host tests, incl. a check that every v1 msg_type is rejected as non-v2.
    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
2026-10-05 feat(mesh): per-origin dedup window for the RELIABLE class (issue 3)
    lib/IceMesh/src/dedup_window.h: highest + bitmap per origin (32 bits by default,
    64 via template for open question Q6), ACCEPT_NEW / ACCEPT_LATE / ACCEPT_RESTART /
    DUPLICATE, LRU eviction, idle origins forgotten after 10 min, fixed memory.
    13 host tests (reorder, window edge, reboot restart, 65535->0 wrap, big jumps,
    LRU, idle expiry, millis rollover, 64-bit window, 3-path delivery = each frame once).
    test/Makefile: 'make sanitize' runs all suites under ASan + UBSan (all green).
    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
2026-10-05 feat(mesh): newest-wins filter for the STREAM class (issue 3)
    lib/IceMesh/src/stream_filter.h: one 'last forwarded seq' per origin, no ID cache;
    older/duplicate copies dropped, d <= -16 = origin restart, silent streams forgotten
    after 10 s, least-recent stream replaced when the table is full.
    7 host tests incl. a 10-minute 4 Hz stream over 3 paths (2400 forwarded, 0 out of order).
    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
2026-10-05 feat(mesh): priority TX queue + LoRa airtime and airtime budget (issue 4 design)
    lib/IceMesh/src/tx_queue.h: fixed-memory queue, 4 priorities (alert > control >
    aggregate > stream), FIFO inside a priority, highest READY item wins (deferred items
    never block others), supersede in place, per-priority depth with drop-oldest,
    TTL per priority (30/30/10/1 s), defer() for CAD backoff, cancelByTag() for
    phase-2 overhear suppression, counters.
    lib/IceMesh/src/airtime.h: SX126x time-on-air (LDRO auto) + token-bucket budget.
    17 host tests incl. a 10-min SF9 hub simulation: 7/7 alerts (max wait 204 ms),
    100/100 aggregates, stream held at 20.1 % airtime, channel at 24.8 %.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
2026-10-05 build: tools/build_check.sh — compile check with arduino-cli (core 2.0.17, pinned libs)
    PlatformIO's registry is blocked from the Cowork shell, but GitHub is reachable, so
    the same core (esp32-2.0.17), toolchains and library versions are installed from
    GitHub releases and driven with arduino-cli. First real compile of the PlatformIO
    tree (C2 + C3): hub 882 KB / 3.3 MB flash, sensor_wroom 724 KB, sensor_c3 711 KB,
    0 errors. lib/IceMesh gets a library.properties so arduino-cli can use it.
    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
2026-10-05 refactor(lora): ESP-NOW callback only enqueues; processing runs in loop() (C9)
    lib/IceMesh/src/rx_ring.h: lock-free SPSC ring (Wi-Fi task -> loop), drops counted.
    4 host tests incl. a 200k-frame two-thread test (clean under ThreadSanitizer).
    lora_node: onEspNowRecv() copies into the ring, loopEspNowRx() drains max 8 frames
    per loop(). Compiles (hub env).
    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
2026-10-05 feat(mesh): TDMA mesh core library (beacon, slots, relay, join, line state, planner)
    Decisions: global 8-bit node IDs, event acks per (hub, node, seq), hubs and chalet
    on Heltec V3, all links 500 kHz (SF9/SF8/SF7) — no 125 kHz single channel.
    lib/IceMesh/src (pure C++11, no Arduino):
    - radio_modes.h SF9/SF8/SF7 @ 500 kHz, airtime, sensitivity estimates
    - tdma_proto.h beacon/echo/hub/join packets, 3-byte line record, health, TLV sections
    - tdma_schedule.h slot timing relative to the beacon end (guard values = estimates)
    - line_table.h hub event latching (ack must match seq: older ack never clears newer event)
    - chalet_nodes.h per-node owner hub, duplicates across pockets, owner ha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
2026-10-06 feat(lora): TDMA radio task replaces the v1 LoRa paths; radio test setting
    src/lora_node/mesh_radio.{h,cpp}: SX1262 owned by a FreeRTOS task (core 1, prio 5).
    DIO1 ISR timestamps (esp_timer) -> REF = beacon start; TX placed with vTaskDelay +
    busy-wait; per-slot SF/BW switching; all protocol logic from lib/IceMesh
    (HubRole / ChaletRole). Chalet = GATEWAY_OFFSHORE: beacon every 1 s, listens to each
    slot, owner-resolved node states -> loop via a queue. Hubs = every other LoRa role:
    search -> sync on beacon or relay echo, own slot, echo + relay duty, JOIN slot and
    random JOIN while unsynced, beacon window then echo windows, free-run 3 frames max.
    main.cpp: removed v1 LoRa TX/RX/relay/aggregate/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
    [config.h, main.cpp, mesh_radio.cpp, mesh_radio.h]
2026-10-06 fix(mesh): review findings on the TDMA firmware (timing, locking, lost updates)
    From a code review of the never-run radio glue:
    - slot TX dropped if > 1 ms late (counted), RX extension after HeaderValid capped at 2 ms
    (< LEAD) instead of 400 ms; chalet join-listen never extends into the beacon
    - standby keeps the TCXO running (STDBY_XOSC) so TX/RX starts don't pay the TCXO delay
    (RadioLib default ~5 ms > 3 ms LEAD); waitIrq spins the last ms instead of a 1-tick sleep
    - meshPrintStatus copies under the lock and prints outside it (Serial blocks ~140 ms)
    - chalet reconciles node states from the mesh every second, so a dropped queue update
    can never hide a trip; missing nodes are created t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
    [main.cpp, mesh_radio.cpp]
2026-10-06 feat(sonar): codec (BASE/DATA/BG blocks), fake sonar scene, hub outbox, chalet store, SEC_SONAR transport
    - block format with the review fixes: node ID per block, first ping index, track ID on every target,
    whole blocks only (relay re-pack keeps whole sections, never cuts a block)
    - planner: FOCUS allowance for the hub reporting the focus node (shrinks first when the plan is too long)
    - beacon flag BF_SONAR_SIM
    - tests: codec round trip/escapes/truncation/fuzz/sizes, outbox/store/relay, end-to-end sim through a relay
    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
2026-10-06 feat(sonar): sonar test mode in firmware (virtual hub nodes, node sim switch, chalet /sonar page)
    - chalet: SONAR ON|OFF / FOCUS n (serial), /sonar page (hole grid, waterfall + flasher), /api/sonar*
    - hub: virtual sonar nodes (SIMNODES 0-4, IDs 128+(hub&15)*8+k), MSG_SONAR from nodes -> SEC_SONAR,
    MSG_SONAR_CTRL broadcast (sim switch + FOCUS) every 1 s and right after a node transmits
    - node: listens 120 ms after each wake-up TX; test mode on = stays awake and streams fake sonar;
    SONAR_SIM_FORCE=1 for bench tests without a chalet
    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
2026-10-06 docs+fix(sonar): SONAR_SIM.md, protocol 6b, D13-D15; keep waterfall on resize, activity from DATA; desktop preview tools
    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
    [main.cpp]
2026-10-06 fix(sonar): node restart detection (random start index + run of old pings); preview tool page lookup; doc table
    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
    [main.cpp]
2026-10-06 feat(sonar): C++ port of Frank's prototype ping simulator + processing chain
    - docs/prototype: the prototype page (reference)
    - sonar_scene.h: 3-frequency raw pings, same scene and PRNG; per-hole variants
    - sonar_proc.h: bottom lock, noise floor, TVG, peak fit, tracker + labels, static scene, hardness
    - tools/proto_reference.js runs the prototype headless -> test/fixtures/proto_ref.txt
    - test_sonar_proc: double build is bit-exact with the prototype (17568 codes, 560 pings);
    test_sonar_proc_float: float build (ESP32) equal at print precision; 6 hole variants
    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
2026-10-06 feat(sonar): block format v2 + SonarSource on the prototype chain
    - codec: up to 5 targets with 5-bit strength (prototype display value), hardness, noise floor,
    echo character (flicker, frequency spread, echo length) every 2nd DATA block; BASE gets hardness
    - SonarSource: scene -> processing -> blocks; processing track IDs mapped to 3-bit slots (0 = bait);
    changed cells and the 4-level static scene from the processing; weeds stay grey
    - store/trace tools follow the new fields; tests updated (104 host tests)
    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
2026-10-06 feat(sonar): /sonar rebuilt on Frank's prototype layout; firmware glue for format v2
    - flasher, 60 s waterfall + overlays (bait line, bottom by hardness, tracks, labels), bottom lock,
    readouts, Under the hole now, Echo character; hole grid; ft default; light/dark; served from flash
    - /api/sonar/pings carries strength, hardness, noise floor, echo character
    - hub SIMNODES (no arg) and node debug print the CPU cost of one fake ping
    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
    [main.cpp, mesh_radio.cpp]
2026-10-06 docs(sonar): SONAR_SIM.md for the prototype chain, protocol 6b format v2, D16-D18
    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
2026-10-06 feat(web): one chalet web suite (Holes / Sonar / Radio / Settings) in the prototype theme
    - one page in flash (send_P); /, /sonar, /radio, /settings open it on that tab
    - FISH ON bar fixed at the bottom, alert sound (3 beeps, not while silenced) and silence on every tab;
    silence state from the chalet (/api/status: silenced, silence_left_sec, sonar_sim, radio_test, role, fw)
    - Holes tab: state, battery, path, last seen, rename, sonar summary + Watch
    - old v1 root/settings/radio and separate sonar pages removed; /remote-config left unlinked
    - tools/web_preview.py replaces sonar_preview.py (mocks every API); docs/WEB_SUITE.md, D19
    Claud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
    [main.cpp]
2026-10-06 sim: whole-system simulation (chalet + 10 hubs + 30 tip-ups + 4 sonars) on the real protocol code
    - radio/timing/ESP-NOW models are estimates; scenarios: baseline, degraded, storm, failures, hostile,
    6-hub field size; variants current / fixA (adaptive SF) / fixB (2 s frames)
    - finding: 10 hubs do not fit the current plan (12 slots, SF9/500, 1 s); 6 hubs work; 60 s heartbeat vs
    90 s timeout shows nodes offline; sonar FOCUS limited by single-try ESP-NOW (docs/SIM_RESULTS.md)
    - tdma_proto.h: MAX_SLOTS overridable (ICEMESH_MAX_SLOTS, default unchanged 12)
    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
2026-10-06 feat(mesh): 16 slots, frame length 1/1.5/2 s chosen by the chalet, beacon commands + network config, ESP-NOW backbone
    - planner: steps the frame up when a hub would lose its slot or fall under 64 B, back down after 20
    beacons that fit (sim finding S1); hubs follow the length in the beacon
    - beacon: cmd target/value (CMD_SET_CHANNEL with countdown, CMD_SET_RELAY), network config byte
    (transport Auto/LoRa/ESP-NOW, ESP-NOW long-range rate, LoRa channel); 8 LoRa channels of 500 kHz
    - eb_link.h: backbone frames over ESP-NOW broadcast, relaying by any device (max 2 hops), dedup,
    TransportPolicy (Auto fallback after 10 s without LoRa, back after 5 beacons; safety nets 60 s)
    - HubRole: beacon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
2026-10-06 sim v2: 3x3 pockets + 10 hubs, foreign LoRa traffic, 8 channels, ESP-NOW backbone with relays, Auto fallback
    planner fixes found with it:
    - a frame 'fits' only if the FOCUS hub keeps its sonar allowance (FOCUS 69 % -> 77-80 % at 10 hubs)
    - a hub not heard directly keeps a relay that worked within 60 frames instead of a direct slot nobody
    hears (2 missed alerts behind the ridge -> 0)
    - HubRole::frameNow(): frame clock from the LoRa plan or the backbone beacon (sonar over ESP-NOW was 0 %)
    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
2026-10-06 feat(net): LoRa channel Auto/fixed, transport Auto/LoRa/ESP-NOW, ESP-NOW backbone with relays in firmware + web suite
    - mesh_radio: 8 channels, chalet activity meter (boot scan + round robin between frames), Auto move
    announced 6 beacons ahead, hub channel search/hop, frame length from the beacon, command queue
    (RESET ALL / SET CHANNEL / SET RELAY), TransportPolicy gating, EB beacon/hub packets, relay + dedup
    - lora_node: settings + NVS, chalet joins ESP-NOW (b/g/n + LR station, LR rate; EBMODE LRONLY fallback),
    serial TRANSPORT/CHANNEL/RELAY/EBMODE, /api/radio fields, DEV_CMD to tip-ups, node timeout 150 s,
    MAX_NODES 48
    - sensor_node: relay mode (NVS, stays awake, floods backbone fr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
    [config.h, main.cpp, mesh_radio.cpp, mesh_radio.h, messages.h]
2026-10-06 fix(chalet): never enable LR on the AP interface (phones could not join); LR on the station only
    ESP-IDF Wi-Fi guide, LR compatibility: an LR-enabled AP beacons in LR and is incompatible with 802.11 b/g/n
    clients. An AP-only chalet now adds its station interface for the ESP-NOW backbone.
    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
    [main.cpp]
2026-10-06 fix(chalet): no LR on the chalet by default - LR cannot be set per interface (esp-idf #4554), it would hide the phone hotspot
    EBMODE NORMAL|LR (bench only), web toggle removed; docs D24 revised, D27 (decision pending: ice side to normal rate).
    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
    [main.cpp]
2026-10-06 feat(net): setup phase, ESP-NOW at the normal rate, every hub relays, network settings behind Advanced
    - TransportPolicy: fallbacks arm after 5 min of stable LoRa beacons; a hub that heard no beacon yet
    also sends on the backbone (searching); armInS()/searching(); tests
    - chalet: starts on the saved channel (boot scan only measures), Auto moves only once armed
    (hub in network 5 min, or 10 min uptime); setup state in /api/radio and /api/status
    - ESPNOW_LONG_RANGE_MODE false on hubs and tip-ups (D28); ice hub in station mode, no AP by default;
    max TX power in every mode on tip-ups
    - ebRelay default on for hubs (D29)
    - page: plain status sentence + Advanced section, setup phase in the sta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
2026-10-06 feat(hub): PRG button v2 - hold 3 s hub hotspot on demand (30 min, kept while a phone is on it) / chalet connect info, hold 10 s network reset, hold bar on screen; serial HOTSPOT, NETRESET
    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
    [main.cpp]
2026-10-06 feat(ui): v2 OLED screens (drawing code, not wired yet) + PC mockup renderer with the real U8g2; docs/SCREENS.md
    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
2026-10-06 feat(ui): OLED sonar glance (all holes), FOCUS mono fish finder, test/simulation page; double press = page action; mockups from the real fake-sonar chain
    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
2026-10-06 feat(sim+sonar): BASE v3 (every target, every 2 s) + 3 min history per hole (/api/sonar/glance); simulation per hole (fake sonar / fake Hall trips) - CMD_SET_SIM, hub own/virtual holes, DEVCMD_SIM to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
2026-10-06 feat(ui): v2 OLED screens wired (model from live state, pages, button + CardKB keys: next/prev/action/silence/home), SIM marks on alert and holes pages
    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
2026-10-06 feat(web): Holes cards show ~3 min of sonar for every hole (glance, /api/sonar/glance), SIM badges; Settings 'Test & simulation' card (per-hole fake sonar / fake fish, all on/off, rate, test holes); 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
2026-10-06 docs: BASE v3, SET_SIM, OLED pages, simulation per hole, web glance; D33-D35
    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
2026-10-06 fix: buffer size (format warning)
    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
    [screens.cpp]
2026-10-06 feat(ui): CardKB arrows + OK navigation, Options page, cabin Wi-Fi status/retry
    - CardKB: left/right = page, up/down = inside the page (holes, sonar, focus hole), Enter = OK
    (footer says "OK:"), Esc = back/home, any key silences a FISH ON
    - Options page (last page): chalet Wi-Fi (status, scan list, typing, retry, forget, channel),
    buzzer, alert hold, link, LoRa channel, simulation per hole (off/sonar/fish/both), network
    reset / reboot with OK/Esc confirm, firmware build date; hub: hotspot, relay, reed polarity
    - Cabin Wi-Fi: keep the router's channel once joined (no forced channel 1), ESP-NOW peer on the
    current channel, retry a router missing at boot (2 min doubling to 30 min), disc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
    [main.cpp, screens.cpp, screens.h]
2026-10-06 feat(ui): CardKB scrolling menu (Esc), Settings page; config.h Wi-Fi wins once after a change
    - Esc (or Enter on Home) opens a Menu: list of pages, up/down + Enter; Esc in a page = back to
    the Menu; Esc in the Menu = Home. "Options" renamed Settings. Pages say "Esc: menu".
    - loadWifiCredentials: a Wi-Fi network changed in config.h and flashed is used once over the one
    saved earlier (FNV hash in NVS); the OLED / web / serial can still change it afterwards
    - Boot "Ready" screen in v2 style with "Esc = menu"; D37, mockups docs/screens/v2_menu.png
    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
2026-10-06 feat(sim): demo network on the chalet - fake hubs and holes without any other hardware
    - mesh_radio: up to 4 fake hubs (real HubRole) x 1-4 holes; packets through onEbHubPacket, the
    backbone beacon fed back (acks, FOCUS, CMD_SET_SIM); light BASE sonar per hole every 2 s, full
    fake fish finder for the FOCUS hole; fake Hall trips per hole; lock only around chalet objects
    - ChaletNodes::forget; demo holes removed from the tables when turned off / smaller
    - Controls: OLED Settings > Simulation (Demo network, Holes per hub), web select, serial DEMO;
    demo holes switch at once (no beacon round trip); names "Demo A1"; DEMO / SIM marks
    - test/test_demo_net; docs SONAR_SIM.md "Demo network", D38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
2026-10-06 perf: OLED hardware I2C + skip unchanged frames, web polls without pile-up, serial PERF
    - OLED: U8G2 HW I2C at 400 kHz (OLED_HW_I2C 0 = previous software I2C); scrDraw sends a frame
    only when the buffer hash changed, after another screen used the display, or every 2 s
    - web: one request of each kind in flight (status, glance, radio, sim, sonar list, pings); sonar
    list only on the Sonar tab; no polling while the page is hidden
    - PERF serial command: avg / max / share of loop, display, web, demo, mesh + free heap
    - D39
    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
    [main.cpp, screens.cpp, screens.h]
2026-10-06 fix: buzzer timed by esp_timer + active/passive type and test; review fixes
    Buzzer (chalet "sounds wrong"): patterns played by a 10 ms esp_timer instead of loop() (loop pauses
    stretched beeps, a beep could last a 1 s message box; on/off times were swapped), silence stops at
    once, Settings > Buzzer test / Buzzer type (active DC or passive 2.7 kHz tone, saved), serial BUZZ.
    Review fixes: status keeps polling in a hidden tab (FISH ON sound), 8 s fetch timeout, demo hole
    IDs 101-112 (200-226 clashed with real hubs 9-12 test holes), demo holes use their running sim
    value (simAnyOn, OLED), queued updates of removed demo holes dropped, sim rate max 62 (0xFF mark),
    first v2 boot keeps a saved Wi-Fi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
    [main.cpp, mesh_radio.cpp]
2026-10-07 feat: FISH ON alarm latched until silenced; depth scaling; sonar processing and display knobs
    - D41: alarm (screen, buzzer, phone) stays after the line resets until silenced or N min (setting);
    silence acknowledges; new trip rings again; /api/status fish = alarm, line = line state
    - D42: SonarProc knobs (sonar_params.h, defaults = prototype, bit-exact test passes): detection
    threshold, peak contrast, confirm/keep pings, max move, dead zone, bottom smoothing, static
    learning, colour range, TVG (+ reserved driver knobs); presets Low/Normal/High; chalet -> beacon
    CMD_SONAR_PARAM -> hubs (NVS) -> tip-ups via SonarCtrlMessage (NVS); resend on new hub
    - Display: OLED Sonar/Focus depth Auto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
    [main.cpp, mesh_radio.cpp, mesh_radio.h, messages.h, screens.cpp, screens.h]
2026-10-07 docs: sonar improvement list mapped to what exists (SONAR_ROADMAP.md)
    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
2026-10-07 feat(sonar): ring-down alarm, level check, near-bait / cover flags, bait per hole, rotation, adaptive rate, trip recordings
    Roadmap items 6, 7, 9, 19, 23, 26, 27, 28, 29 (docs/SONAR_ROADMAP.md), D43:
    - sonar_proc: dt member (ping interval), bottom echo SNR, ring-down monitor (learned normal,
    alarm after 8 pings 15 cm longer), stepRotating (one frequency per ping, compounding over 3)
    - SonarSource: adaptive ping rate (pinghz / idlehz knobs, scene clock keeps real time), frequency
    mode knob, process() entry for the real driver, status flags (ST_RING, ST_NEAR_BAIT,
    ST_BAIT_COVER), BASE also in focus (carries the flags), BASE at once on near-bait
    - codec BASE v4: status 4 b + bottom SNR 6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
2026-10-07 feat(sonar): TUSS4470 driver (written blind), bench firmware, recording + PC replay, bmin knob
    - src/sensor_node/sonar_tuss4470.*: Open Echo shield on the WROOM: SPI registers (odd parity,
    mode 1), RMT burst on IO2, I2S built-in ADC 150 kHz with measured rate, time zero from the
    transmit leakage, 2.5 cm bins at the knob sound speed, power average, 190/200/210 kHz modes,
    converter enable LOW while listening, MCPWM capture of the OUT_4 edge (first burst edge as
    zero), 17-point ADC calibration in NVS. Proposed pins NOT confirmed.
    - sensor node: real sonar when the TUSS4470 answers; serial REC / STAT / KNOB / REG / CAL;
    SONAR_BENCH build (env sensor_wroom_sonar_bench): awake, no hub, B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
    [main.cpp, sonar_tuss4470.cpp, sonar_tuss4470.h]
2026-10-07 fix(sonar): match Frank's power design (no converter enable, TUSS4470 sleep), datasheet register fixes
    - No enable wire to the MT3608 (always on, 12-15 V): SONAR_PIN_BOOST defaults to -1.
    - TUSS4470 sleep mode (TOF_CONFIG 0x1B bit 7) before every deep sleep and when the sonar stops;
    next ping wakes it (5 ms, est.). NCS held high through deep sleep; any SPI frame releases the hold.
    - VDRV_CTRL: VDRV = level + 5 V; was 0x0F = 20 V (impossible from 12-15 V), now SONAR_VDRV_LEVEL
    0x06 = 11 V (est.).
    - BURST_PULSE: 0 = continuous burst; was cycles-1 (cycles 1 -> continuous). Now cycles, never 0.
    - OUT_4 optional (SONAR_PIN_O4 -1).
    - docs: power section, constants, risks (analog echo in the ma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
    [main.cpp, sonar_tuss4470.cpp, sonar_tuss4470.h]
2026-10-07 feat(sonar): drive voltage knob (vdrv 5-20 V), OUT_4 off by default, wake 10 ms
    - New knob vdrv (TUSS4470 VDRV, reg 0x16 = V - 5), default 11 V for the MT3608 at 12.0 V.
    Datasheet: VPWR 5-36 V, VPWR > VDRV + 0.3 V, VDRV max 20 V, full bridge = 2 x VDRV p-p.
    MT3608 at 21 V + vdrv 20 = 40 V p-p, +5.2 dB echo vs the 12 V plan.
    - SONAR_PIN_O4 -1: the 12-core mast cable has one echo wire (VOUT); spare core for OUT_4 later.
    - SONAR_WAKE_MS 10 (datasheet power-up time).
    - docs: drive table, D45.
    Host tests 121/121. Builds: all 9 envs.
    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
2026-10-07 feat(tipup): WROOM reads the spool-shaft Hall latch (flip counting, wake on next flip), Hall on GPIO 27
    - lib/IceMesh/src/hall_latch.h: trip = TRIGGER_FLIPS flips within 10 s, ends after 30 s still;
    boot rules for deep-sleep wakes (level changed = 1 flip, pin wake with same level = 2).
    Plain struct (lives in RTC memory; a constructor would wipe it on every wake), static_assert.
    - sensor node (HALL_LATCH, default on WROOM only): ISR edge count while awake, ext0 wake on the
    opposite level + RTC pull-up before deep sleep, EXT0 wake no longer = alert by itself.
    readReedSwitch() keeps its meaning, so alert / resend / clear paths are unchanged. C3 untouched.
    - REED_PIN 27 on the WROOM (was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
    [config.h, main.cpp, sonar_tuss4470.h]
2026-10-07 fix(review): driver fields per the TI datasheet, 2nd-echo bottom, deep-hole noise floor, no-bait, alarm ack (D47)
    Driver (sonar_tuss4470.cpp): presence check could never pass (reg 0x17 bits 7:5 read-only) ->
    two values on 0x10; LNA gain codes mapped to an ascending knob (10/12.5/15/20 V/V); threshold
    4 bits + comparator enable; BPF code -1/0/+1 per frequency (datasheet table, default 0x1D);
    IO_MODE 0 written; 29.7 mV/dB log-amp slope; time-zero fallback flagged on the BENCH line.
    Processing: second-echo validation of the bottom (a louder school over soft mud no longer
    steals it); noise floor from the quietest water above a bottom near the end of the range;
    bait_m <= 0 = no bait labels / flag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
    [main.cpp, messages.h, sonar_tuss4470.cpp, sonar_tuss4470.h]
2026-10-07 feat(sonar-link): send DATA/BASE blocks once more in the next frame, in ping order (D48)
    No ACK on sonar blocks; the FOCUS allowance has room (~55 B used of 180). SonarOutbox keeps each
    DATA / BASE block for one repeat in a LATER frame, placed in ping order (a repeat sent after a newer
    block was dropped by the chalet as late: that ordering was the whole gain). BG not repeated. A block
    already sent once is evicted first. Store: a BASE with the same ping index is "heard", not re-recorded.
    test_tdma_sim through a relay: 83 -> 95 % of focus pings at 10 % loss per link, 50 -> 74 % at 20 %.
    New test_outbox_repeat_in_order; sim thresholds raised to 90 / 65 %.
    19 suites / 131 tests, ASan/UBSan clean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
2026-10-07 refactor(web): the chalet web suite lives in web/suite.html (generated header), Holes tab redesigned
    - web/suite.html is the source; tools/gen_web.py writes src/lora_node/web_suite.h (PlatformIO
    extra_scripts and build_check.sh run it; the header is committed too). main.cpp includes it.
    Build size identical before the UI changes (1066885 B).
    - tools/web_preview.py reads web/suite.html and now fakes /api/sonar/knobs, /api/node/bait,
    /api/trips and the line/bait/trips fields.
    - Holes tab: one card per row on phones (two columns were cramped), compact header on phones,
    one meta line (#id - link - seen), buttons instead of links (Watch / Set bait / Rename),
    summary owned by the glance,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
    [main.cpp]
2026-10-07 refactor(chalet): split main.cpp into modules, alarm rules host-tested, OLED Holes wording (D49)
    No behaviour change. main.cpp 7484 -> 2751 lines:
    - chalet.h: NODE_* defines, includes, types, every global as extern (defined in main.cpp), prototypes.
    - web_server.cpp (routes, JSON API, remote config; also the radio / sonar / knobs / sim handlers),
    wifi.cpp, ui_input.cpp (CardKB, menu, Settings pages, text entry), settings.cpp (NVS: settings,
    names, knobs, bait), alerts.cpp (alarm loops, history, silence, buzzer).
    - lib/IceMesh/src/alarm_latch.h: the FISH ON latch rules (start / ack / lineReset / hold / active);
    NodeState.alarm replaces alarm_ms + alarm_acked. test_alarm_latch: 5 cases,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
    [alerts.cpp, chalet.h, main.cpp, messages.h, screens.cpp, settings.cpp, ui_input.cpp, web_server.cpp]
2026-10-07 tools: flash.html (pick board + purpose + ID -> one command, checks before/after) and flash.py (writes devices.ini env, pio upload)
    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
2026-10-07 fix(sonar): DEVICE_ID presence check, VDRV_READY wait, per-burst VDRV charge (quiet receive), burst faults on BENCH (D50)
    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
    [main.cpp, sonar_tuss4470.cpp, sonar_tuss4470.h]
2026-10-07 feat(web): pocket map on the Holes tab, hole positions stored on the chalet (/api/node/pos), header CSS fix (D51)
    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
    [chalet.h, main.cpp, settings.cpp, web_server.cpp]
2026-10-07 docs: backlog - pin holes with the chalet GPS at installation (idea)
    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
2026-10-07 web(sonar): lake bed vs weeds colours, 'At bait depth' wording, Simple (Noise filter / Water) vs Advanced knobs with plain-language help
    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
2026-10-07 chore: cabin Wi-Fi credentials in src/lora_node/secrets.h (gitignored, secrets.example.h committed); config.h clean; devices.ini: chalet100
    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
2026-10-07 feat(web): beam width per depth (D52, beam angle setting); review: SPI status bit offset, 1 ms burst settle, map drag vs refresh
    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
2026-10-08 sonar: beam angle default 14 deg (the ordered 200 kHz transducer, -3 dB 14 +/- 1)
    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
2026-10-09 Sonar D53: vdrv default 20 V, vmode knob (Open Echo proven path default)
    Read the Open Echo firmware (Neumi/open_echo). Confirmed our SPI frame, BPF in 0x10,
    LNA codes, threshold encoding and burst flow. Their in-water results (fish 18 m, bottom
    38 m) ran 15-20 V at the lowest gain with the VDRV regulator always on (0x16 = 0x0F).
    - vdrv default 11 -> 20 (MT3608 to 21 V; KNOB vdrv 11 while it is still 12 V)
    - new knob vmode: 0 = regulator always on, no VDRV_TRIGGER (Open Echo, default);
    1 = DIS_VDRV_REG_LSTN + 20 mA + VDRV_TRIGGER/VDRV_READY before each burst (datasheet)
    - init writes 0x0F; web help + preview; docs (local)
    Claude-Ses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
2026-10-10 Sensor D54: radio-quiet sonar capture (wait for ESP-NOW TX before each ping)
    nowSend() counts every ESP-NOW frame against the send callback; radioQuietForPing()
    waits (max 40 ms) for nothing in flight + 2 ms guard before tuss::ping(). Counters on
    the BENCH line. Docs: decisions D54, SONAR_DRIVER.md (local).
    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
2026-10-11 Sonar: boost EN is sleep-only; env sensor_pod_v03 for the integrated pod board
    SONAR_PIN_BOOST no longer toggles during a ping (VPWR feeds the TUSS4470 regulator, D53
    vmode 0): HIGH while the sonar runs (20 ms settle on wake), LOW + held through deep sleep.
    SONAR_PIN_O4 / SONAR_PIN_BOOST overridable by build flags. New env sensor_pod_v03
    (ESP32-WROOM-32UE on the pod board v0.3): OUT_4 on GPIO32, MT3608 EN on GPIO33.
    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
